RobaLinan/dual-ink-reader/DESIGN.md

# 双屏对折电子书 · 设计文档（方案 v4）

> 参考项目：The Open Book（单屏，字库/分页经验）、atomic14 diy-esp32-epub-reader（软件分层）、**Diptyx**（双 5.83" 对折，硬件形态几乎相同，MIT）。
> 屏幕：GDEY0583T81 ×2，648×480，UC8179 控制器，138dpi，带转接板模块。
> 全刷 3s / 快刷 1.5s / 局部 0.3s（数据手册 §7.2）。

## 1. 引脚分配

### 1.1 ESP32-S3 N16R8（目标板）
```
墨水屏（SPI2，两屏共用 SCK/MOSI）：
  SCK 12, MOSI 11
  左屏：CS 14, DC 15, RST 16, BUSY 17
  右屏：CS 18, DC 21, RST 47, BUSY 48     ← 右屏构造时 mirrored=true
SD 卡（SDMMC 1-bit，4-bit 实测不稳，见 §5.7）：
  CLK 38, CMD 39, D0 40（D1/D2/D3 不接线，41/42/13 空出备用）
按键（低有效，内部上拉 + 板载 10k；**不参与唤醒**——唤醒只走霍尔，2026-10-08 定案）：
  PREV 1, NEXT 2, MENU 9, FONT 10
霍尔 DRV5032 OUT：4    （全极性开关型；误买锁存型则唤醒逻辑改"任一沿都醒"）
电池电量：**当前不用**（原理图已删 BAT_SENSE，GPIO8 空出）；（如需：优先电池包自带指示灯，否则 5V 分压进 GPIO 8（ADC1_CH7，软件滤波、不加电容））
备用：5, 6, 7、41、42、13
```
避开：strapping 0/3/45/46、USB 19/20、**内部 Flash 占用的 26-32**、八线 PSRAM 占用的 33-37、UART0 43/44。
> P3 实测教训（2026-09-24）：SD CMD 误接 GPIO29 → `sdmmc_init_ocr` 0x107
> （卡无应答）。26-32 是 N16R8 内部 Flash 引脚，硬件占死，任何外设都不能用。

编译 FQBN：`esp32:esp32:esp32s3:PSRAM=opi,FlashSize=16M,PartitionScheme=app3M_fat9M_16MB,CDCOnBoot=cdc`
> 分区表实际以 sketch 根目录 **`partitions.csv`** 为准（platform.txt prebuild 钩子
> source > variant > build.partitions 自动覆盖菜单项）——菜单选 `app3M_fat9M_16MB`
> 只为借它的 `upload.maximum_size=3MB` 做体积上限检查。详见坑 22。

### 1.2 经典 ESP32 Dev Module（❌ 已废弃 —— 代码不再支持，仅存档）
> P3 起 sketch 只面向 ESP32-S3（`CONFIG_IDF_TARGET_ESP32S3` 分支已删）。
> 旧面包板接线：BUSY 13, RES 12, DC 14, CS 27, SCK 18, MOSI 23。

## 2. 电源
```
5V 电池包 → 开发板 5V/VIN 脚
开发板 3V3 脚 → 屏L/屏R VCI（各加 100µF+100nF 就近去耦）、SD 模块、DRV5032、按键上拉
```
**电池包选型硬指标：必须无自动关机/支持常开**（深睡整机几十 µA，普通充电宝低电流自动断电后唤不醒）。
**电流尖峰预案**：双屏重叠刷新峰值 300-400mA。原理图已放 **Ams1117** 位（3P 端子 + R12/R13 0Ω，**默认 DNP**，WIRING §3.8）；若实测重启 → 贴上模块（注意它与开发板 3v3 输出并联对顶，且静态 ~5mA 会毁掉深睡 µA 目标）。
深睡时屏 VCI 保持供电（DSLP 约 1µA），唤醒直接差分刷新。

## 3. 驱动要点（src/EinkPanel.* + src/DualEink.*）

与 vendor 代码（legacy/EPD.cpp）的本质区别：
1. 引脚全部构造参数化 → 可实例化左右两屏
2. `waitIdle(timeout)` 带超时 + 喂狗（vendor 是无超时死循环）
3. `showDiff(prev, next)` 的 DTM1(0x10) 写**真实上一帧**（nullptr=全白）；
   vendor 每次灌 0xFF，等于控制器以为屏本是白的 → 残影根源
4. 三档速度 = 寄存器组合：
   | 档位 | 0x50 CDI | 0xE0 | 0xE5 | 实测（单屏 / 双屏重叠 L+R） |
   |---|---|---|---|---|
   | FULL | 0x21 0x07 | 0x00 | — | **3749ms / 3815ms** |
   | FAST | 0x29 0x07 | 0x02 | 0x5A | **1232ms / 1306ms** |
   | PARTIAL | 0xA9 0x07 | 0x02 | 0x6E | ~0.3s（待实测） |
   0xE5 本质是**强制温度寄存器**，靠假装高温让控制器从 OTP 挑快波形；
   开关在 **0xE0 的 TSFIX(bit1)**：1=用 E5 强制值，0=用内置温度传感器（复位默认）。
   ⚠️ `setSpeed(FULL)` 必须把 0xE0 写回 0x00，否则快刷后再全刷会沿用强制温度的
   快波形 → 清不干净残影（已修，UC8179.pdf §46/§49 确认）。
   5. `DualEink::present()`（P2）：左灌帧→DRF→趁左 busy 给右灌帧→DRF→等两屏 idle。
   对照 Diptyx `DisplayPictureBoth()`，同一形状；单屏串行 2×1.3s → 重叠 ≈max+60ms
5. `mirrored=true`：流式发送时做字节序反转+位反转（右屏物理倒装）
6. BUSY 高电平 = 空闲（此模组极性，与 vendor 注释 "=0 BUSY" 一致）
7. **页面方向（2026-09-28 改：短边为横边的竖版页）**：屏恒是 648×480 横版
   显存，排版则按竖版页 `PAGE_W`(480) × `PAGE_H`(648) 走。旋转不自己拷缓冲，
   交给 `Paint_NewImage(..., PAGE_ROTATE)` —— GUI_Paint 的 `Paint_SetPixel`
   逐像素做坐标映射（**90 = 页顶朝屏右边**，阅读时把设备逆时针转 90°；
   270 = 反向，改 `EinkPanel.h` 的 `PAGE_ROTATE` 或编译加 `-DPAGE_ROTATE=270`）。
   所有绘制（`Paint_Draw*` + `CJK.drawGlyph`）都经 `Paint_SetPixel`，所以零额外
   缓冲、零旋转拷贝；差分/DTM1/`mirrored` 仍在显存坐标上原样工作。
   ⚠️ 代价：`Paint_SetPixel` 边界判断是 `>` 不是 `≥`，**逻辑 x=480 会写穿显存**
   （旋转后 x→显存行号，SetPixel 内部拦不住）→ 三处钳位是硬需求：页眉超长
   截断（`TxtBook::drawHeader`）、行宽硬上限 464（`HARD_PX = PAGE_W-16`）、
   CJK ink 出界丢弃（`CjkFont::drawGlyph`）。离屏回归见 §6
   `tools/rot_layout_test.cpp`（哨兵带验证最坏排版零越界 + 反例确认 x=480 必穿）。

**P1 实测数据**（eink.ino demo，串口 115200，ESP32-S3 实测 2026-09-23）：
```
full refresh #0: 3749 ms (ok)
fast refresh #1: 1232 ms (ok)
fast refresh #2: 1232 ms (ok)
fast refresh #3: 1232 ms (ok)
```
⚠️ P1 首版"刷完花屏"根因：demo 漏调 `Paint_NewImage()` → GUI_Paint 全局
Width/Height/Scale=0，`Paint_Clear` 空转、所有绘制被边界检查丢弃，帧缓冲一直
是 malloc 垃圾。SPI/时序本身没问题（耗时数据是真实的）。

**P2 实测数据**（双屏 `DualEink::present()` 重叠刷新，2026-09-23）：
```
both panels OK - dual overlapping mode
full refresh #0: 3815 ms (ok)     ← 单屏 3749ms，重叠代价仅 +66ms
fast refresh #N L+R: 1306 ms (ok) ← 单屏 1232ms，重叠代价仅 +74ms（右屏灌帧 60ms 藏在左 busy 里）
100 次连刷（每 5 快插 1 全）：0 超时 0 花屏 0 重启
```
⚠️ P2 首版"上电全刷花屏"根因：setup 把页 0 画进 fbShown，而 refreshPair()
固定拿 fbDraw 当新数据 → 首帧 DTM2 = malloc 垃圾；且 setup 漏了 swapPair()。
修法 = 四缓冲先 memset 白 + 画进 draw 缓冲 + 收尾 swap（双缓冲纪律：
shown 永远 = 屏上真实内容）。
**双屏同刷电流峰值未实测**（手头无表）；100 次无重启 = 供电间接通过，
若日后出现重启按 §2 预案上 AMS1117。

## 4. 分阶段路线
| 阶段 | 内容 | 验收 |
|---|---|---|
| P0 ✅ | 去损坏引用，旧驱动移 legacy/ | 编译通过 |
| P1 ✅ | EinkPanel 类 + 翻页 demo | 全刷/快刷实测、20 次快刷残影可接受 |
| P2 ✅ | 第二块屏 + `DualEink::present()` 重叠刷新（对照 Diptyx 固件） | 整页 ≤1.8s ✅（实测 1306ms）、100 次无花屏无重启 ✅、双屏电流待补测（无表；100 次无重启=间接通过） |
| P3 ✅ | SDMMC + UTF-8 + 字体 + 断行 + 分页 + 霍尔深睡（2026-09-24 收官；4 键已挪 P6） | TXT 中英混排；合盖深睡开盖 2s 恢复 —— 全过 |
| P4 ✅ | miniz + tinyxml2（锁版本，src/VENDOR.md）+ 书库 + 进度 + **EPUB 插图** | EPUB 读完一章不崩不 OOM（>280KB 章节流式）✅、章间翻页/切书/进度回页 ✅、插图清晰不重启 ✅ —— 屏上实测通过（2026-09-28；插图首测揪出坑 21 两 bug 已修复测） |
| P5 ✅ | 跨页语义：左 N / 右 N+1（DualEink 双屏 + renderPair/turnPage 对页栈 48 深） | 翻 50 页内容连续 ✅ |
| P6 ✅ | 3D 打印底板 + 铰链 + 10 芯排线 + 板载按键 + **4 键逻辑**（src/Keys ISR 边沿队列 + poll 判定）；**备料清单见 `BOM.md`** | 连续翻页无复位 ✅；唤醒定案只霍尔走 EXT1 ✅；按键电气台架 10 连按不漏不错位 ✅ |
| P7 | 打磨：电量/封面页/VCOM 逐屏标定/温度补偿 | 待机 ≥1 月 |

> **P3 收官 ✅（2026-09-24，全项屏上目检通过）**：
> - **SD**：分目录 `/fonts` `/books`（根目录旧布局兜底）；冷上电挂载
>   **指数退避重试 ×5 + "/" 根目录探针**防"begin 成功但开文件失败"的半成功
>   挂载（坑 15 定案：卡与双屏共用 3V3、上电爬升慢，固定 100/200ms ×3 覆盖
>   不住最坏就绪窗口，连挂 9 次全败实测；根目录探针顺带修掉"冷开候选 1 静默
>   换书"——开机读英文、唤醒读中文的根因）
> - **排版**：UTF-8 中英混排分页——汉字按字断行、英文按词断、避头尾、
>   纯英文不回退、EOF 回卷；Unifont 整载 PSRAM（板型必须选 OPI，`[mem]` 常驻
>   探针可观测）
> - **字体自定义**：三档字号 16/24/32（串口 `s`）+ 四家族 EPF1 离线字库
>   classic/serif/sans/kai（`tools/mk_fontpack.py` 离线光栅化 → SD 扫描自动
>   发现 → PSRAM/heap/桶缓存三级装载 + Unifont 回退链 → NVS 持久化，
>   串口 `f` 切换即预览）
> - **霍尔深睡全链路**：合盖 300ms 防抖 → 屏上对页位置存 RTC 内存 → SPI 8 脚
>   `gpio_hold`（防深睡浮空噪声刷屏）→ EXT1 深睡；开盖唤醒重画对页进 RAM、
>   **只同步 shown 不推送面板**（VCI 常供图像没丢）= 零闪烁恢复原页，下一翻页
>   diff/DTM1 正确；loop 5s 整段 delay 改 20ms 分片轮询。台架
>   （`hall_sleep_test/`）验证 EXT1 唤醒 526–576ms、醒后仍合盖自动再睡；
>   集成后合盖睡/开盖回页/醒后翻页不花屏/多轮循环/RST 释放 hold 全过
> - **交接**：4 键过渡期用串口 `f`/`s`（`setTier`/`setFamily` 接口已备好），
>   4 键 / 电池包不自动关机验证在 P6
>
> 下一步 → **P5**：跨页语义。
>
> **P4 ✅ 收官（2026-09-24 编译 + 主机端管线验证 → 2026-09-28 屏上实测通过）**：
> - **vendored 锁版本**：miniz 3.0.2（zip 解压，原样）+ tinyxml2 10.0.0
>   （打 1 类补丁：定义 `TIXML2_PSRAM_POOL` 时 MemPoolT 4KB 池块 +
>   `_charBuffer` 文档缓冲走 ps_malloc，失败回退 malloc——>280KB 章节的 DOM
>   不挤 250KB DRAM；补丁位置/升级注意见 src/VENDOR.md）
> - **一章一转换**（`EpubBook` 组合 `TxtBook`，排版引擎零重写）：
>   miniz 流式解压章 XHTML → 片内 LittleFS 临时文件（坑 6 定案路径；**坑 18
>   起临时文件不写 SD**，SD 写会物理锁卡）→ 整章读进 PSRAM
>   （444KB 实测装得下）→ tinyxml2 解析 → DOM 抽正文（跳过 style/script/head，
>   块级补 \n，空白折叠，连续空行封顶 2）→ 2KB 缓冲写 LittleFS 临时文本 → TxtBook
>   当 TXT 翻（三档字号/四家族/避头尾全继承）。解析失败自动降级"剥标签"兜底
> - **章末推进**：TxtBook 加 setLoop(false)/hitEof()；右页中道结束画空白页，
>   下一对页自动进下一章，坏章自动跳过（guard 防死循环），全书读完回卷
> - **实体预替换**：tinyxml2 只认 5 内置实体、其余原样透传 → 解析前压缩式
>   单遍替换 &nbsp; &ldquo; &mdash; &hellip; 等（UTF-8 BOM 顺手剥掉）
> - **书库 + 进度**：开机扫 /books/*.txt + *.epub（根目录旧布局兜底），串口
>   `b` 切下一本；进度（路径+章号+章内偏移+页号）存 NVS，每 10 对页/切书/
>   深睡时落盘，冷启动按存档恢复；深睡 RTC 增加章号，开盖回页对 EPUB 同样零闪烁
> - **顺手修**：CjkFont::setFamily 同家族同档短路（否则 EPUB 每章切换会把
>   kai 几 MB 字库包从 SD 反复整载）；TxtBook::open 允许重开（关旧文件）
> - **测试书**：`tools/mk_test_epub.py` 生成 assets/books/test.epub（3 章，
>   第二章 444KB >280KB 验收线；混入中文/英文/实体/弯引号/br/嵌套/脚本）；
>   主机端用同款代码 + vendored tinyxml2 验证：三章全解析成功、实体全替换、
>   script/style 零泄漏、无三连空行

**P4 插图 ✅ 收官（2026-09-28，主机端路径解析验证 + 屏上首测 → 揪出两个
bug 已修（坑 21）→ 复烧回归通过）**：
- **管线**：转换期 `collectText` 遇到 `<img>`/`<image>`(svg 封面) 不写文本，
  写 `[[img:zip内路径]]` 标记行（src 相对本章 XHTML 解析：`../` 折叠 + `#` 截
  锚 + %XX 解码 + 空格转 %20 防拆词）→ TxtBook 排版到标记 = 独占一块行高：
  回调量高（只读文件头）→ 页中放不下整图推下页（新 s_rewindPos 页尾回退，
  与行回退互补）→ 页首硬压进一页防死循环 → EpubBook 解压图片条目到
  LittleFS 临时文件（同路径缓存，防 restartPair 重复解压）→ `EpubImg` 解码
- **解码**（详见 src/VENDOR.md）：JPEG = vendored **ChaN TJpgDec R0.03**
  （块回调无整图缓冲，RGB565 输出，3.5KB 工作区；坑 19：S3 ROM 版 esp_rom_tjpgd
  调试不可达已弃用——根因是 ChaN 输入回调"NULL buf = 跳字节"约定未实现）；
  PNG = PNGdec 库（35KB 对象堆分配，栈放不下，坑 16 同因）。
  两路都走 4×4 Bayer 有序抖动 → Paint_SetPixel 落帧缓冲（白底只点黑）；
  渐进 JPEG / 隔行 PNG / GIF / WebP 跳过不阻塞排版
- **主机端验证**：路径折叠镜像脚本对三本书全量过——test 3/3（含 ../ 引用）、
  alice_rackham 42/42、christmas_carol 11/11（含 svg xlink:href 封面）全部
  命中 zip 条目；三书图片路径最长 44B（标记 ≤52B，词缓冲 192B 无溢出）；
  全部 JPEG 均 baseline、PNG 均非隔行（解码器可解）。test.epub 的假 8B pic.png
  换成真 400×240 灰阶渐变 PNG（考缩放 + 抖动）
> - **验收清单 ✅（2026-09-28 屏上实测全过）**：①开test.epub 翻完 444KB 章不崩不 OOM
>   （串口盯 `[epub] chapter ... psram free=` 与 `[mem]`）②章间翻页连续无重页
>   ③合盖开盖回页（含章号）④`b` 切书 ⑤字体/字号切换即预览对 EPUB 生效
>   ⑥插图（alice_rackham）灰阶抖动观感可接受、无涂抹、翻到图页不重启
>   （坑 21 修复后复烧）—— 插图显示效果定案，后续不再动解码/抖动参数
>
> **P6 ✅ 收官（2026-10-08 → 2026-10-12，PCB 实装 + 按键电气台架 + 4 键逻辑 + UI 美化）**：
> - PCB 打样回来已装机，屏/SD/霍尔/按键功能正常（按键为首次上板）
> - `key_test/`（P6 新增台架，对应 `hall_sleep_test/`）：上电空闲 4 脚全高
>   （原理图 BTN_* 误标 GND 坑实测排除）、4 键各 10 次连按 10/10/10/10
>   不漏不错位、去抖 20ms 全程 `bnc=0`、2/3/4 键组合正确识别且计数同步
>   （无连锡）、静置 80s 电平恒高零漂移；长按 115–800ms → **短按阈值
>   定 ~250ms** 依据
> - ✅ **唤醒定案（2026-10-08）：按键不参与唤醒，只有霍尔走 EXT1** ——
>   `eink.ino:491` 的 `ANY_HIGH` 一行不改，按键低有效不进掩码，极性冲突
>   随之消失（原备选"改 ANY_LOW+霍尔反相 / 按键改 ULP/GPIO wake"全部不需要）。
>   代价：合盖深睡时按按键不叫醒设备（阅读流 = 开盖醒 → 按键翻页，可接受）；
>   深睡中按过的键表现为"醒后首读为低"，4 键逻辑忽略开机首个低电平
> - ✅ **4 键逻辑已落地（2026-10-08，编译 993KB/75%，已烧录待屏上验收）**：
>   - `src/Keys.h/.cpp`：**ISR 边沿队列 + poll 判定**——刷新阻塞 1.3s/3.8s，
>     轮询会把刷新窗口内的按压整段漏掉（翻页时最常按的就是刷新中），ISR 只
>     记 (时刻,脚,电平) 进 16 槽环形队列，去抖 20ms/长按 250ms/连发 300ms
>     全在 poll 判；醒后被按住的键不补发按下（不产生幽灵事件）；电平兜底
>     （m_down 与引脚背离满一个去抖窗 → 补发释放，防抖动沿卡死成幽灵翻页）
>   - `eink.ino turnPage()`：**对页历史栈 48 深**（Book 接口只前进，上一页靠
>     坐标回退 restorePair→renderPair）；连按并批成净位移（一次刷新 1.3s 内
>     攒下的按压跨 N 页只刷一次屏，中间页也进历史栈可逐页回退）
>   - 键位：Prev/Next 翻页（长按连发）、Font 短按字号 `s`/长按家族 `f`、
>     **Menu 短按 = 主页（选书）/ 长按 250ms = 系统菜单**（P7 改，见 §9）；
>     菜单内 Prev/Next=上下、Font 短按=执行、Menu=退出；主页内 Prev/Next=
>     上下选书、Font 短按=打开选中书（`src/HomePage.*`）
>   - **自动翻页默认关**（串口 `a` 开 = 台架测试用），真实阅读不自翻
> - 📌 **已记录在案、暂不修的边角问题（2026-10-08 代码评审）**：
>   ① Font 按下发生在菜单打开前、松开在打开后 → RELEASE 会误执行菜单当前项
>     （`g_keyDown` 不区分按下时的菜单状态；修法：开菜单时清一次 `g_keyDown`）；
>   ② 菜单内按住滚动比书页模式慢一拍：菜单只认 PRESS/REPEAT，LONG 事件被吞，
>     首拍连发要等"长按+连发"周期（书页模式 LONG 本身也算一步，两侧节奏不同）；
>   ③ 开机窗口（setup 数秒）内按的键会攒成真实事件、boot 后集中兑现 → 可能
>     开机即翻页/开菜单（串口侧有 `harvestRx("boot")` 先例；按键侧如需冲洗：
>     setup 末尾空转一轮 `keys.poll()` + `while (keys.take(ev))`）
> - ✅ **屏上验收通过 + UI 美化（2026-10-12）**：4 键翻页/回退/菜单/字号全过；
>   主页/菜单 UI 美化（选中项实心三角+粗下划线、分节标题带方块标记、状态
>   实心/空心圆点指示、页脚居中、粗细分隔线区分层级）

## 5. 已知的坑（详见方案文档）
1. 电池包自动关机 → 深睡报废（选型硬指标）
2. 双屏同时刷新电流尖峰 → LDO 重启（大电容去耦优先，AMS1117 兜底）
3. 双屏 SPI 争用 → 严格"选片→传输→释放"，提前 return 前先放 CS
4. 绝不在 MCU 上排整本书（The Open Book：20 分钟且会崩）→ 按章排版 + SD 缓存
5. CJK：UTF-8 在分词处解码；CJK 按字符断行 + 避头尾；Unifont 存 SD 流式查表
   **→ 已落地（2026-09-24）**：字库 = GNU Unifont 18.0.01 → `tools/mk_unifont.py`
   生成平坦 `unifont.bin`（65536×32B = 2MB，`offset=cp*32` 免索引直接 seek；
   8×16 半宽左对齐补零到 16 列；辅助平面 66225 条 BMP 之外跳过；缺字画 16×16
   空心方框区分"缺字/空白"）。`CjkFont` 优先整块 ps_malloc 进 PSRAM，失败回退
   逐字形 SD seek+read。排版按像素宽：ASCII 11px / CJK 16px / 空格 11px，
   **竖版页 480 宽**（方向见 §3.7）：软预算 448px，硬上限 464px（`PAGE_W-16`，
   `Paint_SetPixel` 边界是 `>` 不是 `≥`，逻辑 x=480 会写穿显存 → 悬挂吞右边距
   也绝不能超 464）。断行四层：
   避头悬挂 → 上一 token 推挤到下一行同行（携带的前导空格剥离并恢复原
   pendingSpace）→ 普通换行 → 超长词 cutPoint 硬切。西文弯引号/长横线仍归一
   ASCII 走 Font16，英文行宽与旧版一致（不回退）。`Font12CN/Font24CN` 只有
   extern 无定义，链接不过 —— 不可用。
   **三档字号（2026-09-24 增）**：`TxtBook::setTier(16/24/32)`。S=Font16 原生
   11px+Unifont16/行高18/33行；M=Font24 原生 17px+Unifont 1.5× 最近邻/28/21行
   （笔画略参差，可接受）；L=Font16 点阵 2× 放大 22px+Unifont 2×/36/16行（整齐）。
   运行期切档：串口 `s` / **Btn_Font 短按**（P6）；默认档改 `TxtBook.h` 的
   `TXT_SIZE_PX` 再编译。
   行数不再写死，`updateGeometry()` 按 `TXT_BOT(=PAGE_H-18)` 与墨迹盒算（换页高
   只动 `TXT_BOT`）。软行宽 = 464−汉字档宽（448/440/432），悬挂后仍 ≤464 不越屏；
   缺字方框随档 1px/2px 加粗。页眉固定 16px 不随档位，长文件名在 `drawHeader()`
   按 480 宽截断。
   **字体自定义（2026-09-24 增，Kindle 式）**：家族包 `font-<名>-<档>.bin`（EPF1）
   离线从任意 TTF 光栅化（`tools/mk_fontpack.py`），拉丁带真实 advance（比例宽度），
   汉字/全角等宽；一笔紧凑 ink（cp/adv/xy 偏移/w/h/bits），PSRAM 整包 → heap →
   SD 桶缓存三级装载，查表走 u32[257] 桶索引线性扫（≤256 条）。缺字回退：
   家族包 → Unifont（对齐包基线）→ 方框。行几何随包度量联动（基线/行盒/行距
   = 盒+档宽/8）；软预算与 classic 同为 464−档宽（悬挂另有显式 HARD 检查兜底）。
   切换：串口 `f`=换家族 `s`=换字号（**P6 已绑按键**：Btn_Font 短按=s / 长按=f，
   见 WIRING §3.4），选择存 NVS 断电保留；
   `restartPair()` 回跳当前对页立即重排 = 切换即预览。家族 classic/serif/sans/kai
   四款全就绪（kai=霞鹜文楷 43433 字形，2026-09-24）。 ink 出界自兜底（竖版页逻辑 x≤479/y≤647，Paint 边界是 > 不是 ≥）。
6. EPUB >280KB 章节崩分配器（atomic14 #73）→ 先解压到临时文件再流式（坑 18 后 = 片内 LittleFS）
7. SDMMC × core 2.0.17 × S3 兼容性 → **P3 首验（2026-09-21）：4-bit 不稳定，定案 1-bit @20MHz；写 2MB / 1417ms ≈ 1.41MB/s**。**二验（2026-09-24）：正式引脚 38/39/40 挂载成功，/test.txt(151KB) 流式分页正常（24 行/页，读+渲染 ~30ms/页，对比 1.3s 刷屏可忽略）**。
   ⚠️ 踩坑：初始化 `0x107`（卡无应答）→ **CMD/D0 需要内部上拉兜底**（`pinMode(INPUT_PULLUP)` 再 `setPins`）——模块没焊总线上拉时 CMD 浮空；8.21 的 one_bit_write 带这两行、初版 Storage 漏抄。D1/D2/D3 1-bit 用不到，但**卡座侧上拉到 3V3 后写路径转稳**（09-28 复测，见坑 18 末段）——用 10kΩ 上拉，**别直连 3V3**。
   **写后读回校验 → P4 首测未过（2026-09-28，坑 18）**：正式引脚写 ~3KB 即 0x109
   锁卡；EPUB 已改片内 LittleFS 临时文件绕开 SD 写。
   **复测通过（2026-09-28 晚，`sdcard/one_bit_write` v3）**：正式引脚 38/39/40 @20MHz
   连续两轮 **2MB 写 + 整档读回校验全过**，读 1.92MB/s、写 0.25MB/s（4KB/次；
   32KB 大块吞吐用 G 档待测）。⚠️ 归因未收口：断电重插（锁死卡复活）和
   **DAT1/2/3 接 3V3** 是同时做的两件事，A/B 复测（断开 DAT1-3 再跑）没做。
   **→ 同上电三轮复跑（09-28 晚，坑 18 末段表）翻案**：4KB 多块写 **3/3 必挂**、
   512B 单块写 2/3 过 2MB、节流与降频全无效 → 写路径仍在边际，**写小块只是缓解**。
   **固件已落地（09-28）**：`NetSvc` 上传 `/books` 改 512B 对齐分块写（强制单块
   CMD24，HTTP 分块先在 `m_upBuf` 攒够一扇区再落盘）+ 落盘字节对账 + close 后回读
   校验 size + 失败先 `Storage::recover()` 再删半截文件。原实现一失败就把整张 SD
   锁死到断电、且弹"卡满或写保护"误导文案。
   **→ 首测（09-28）仍失败**：512B 单块写在 289.6kB 文件的第 **29696 字节（10%）**
   就挂，且 recover 报 OK 后 `remove` 仍 0x107 = 恢复假阳性（挂载≠能写，见坑 18 末段）。
   待补：深睡唤醒后重新挂载、G 档 32KB 大块写速、DAT1-3 断开的 A/B 复测、
   **换卡排除 + 卡座 VDD 去耦 + CMD/D0 47k 上拉（排查三件至今一件没做）**；
   真不稳再回退 SPI（接口不变）
8. 同型号两块屏 VCOM 不一致 → CDI(0x50) 左右分开标定（Diptyx 做法）
9. 残影 → 每 5 次快刷插一次全刷
10. `0xE5` 强制温度 → 对比度略降；后续用面板温度传感器（0x40 TSC/0x43 TSR）补偿
11. 结构装配时 USB 座外壳通孔必须焊/固定，否则连焊盘撕掉（Open Book 教训）
12. GUI_Paint 用前必须 `Paint_NewImage(buf, W, H, PAGE_ROTATE, WHITE)`（W/H 是
    **显存** 648×480，旋转定竖版页方向，见 §3.7），之后各画布只
    `Paint_SelectImage` 切换 —— 漏了 NewImage 不报错不崩溃，只是全部绘制静默丢弃
    （P1 花屏根因）。宽高/旋转只认 NewImage 那一次，SelectImage 只换指针
13. 右屏 BUSY 用 GPIO48 = DevKitC-1 的 RGB LED 脚：LED DIN 高阻无电气冲突，
    但刷新时 BUSY 信号会让 LED 闪 —— 属正常现象，别当故障查接线
14. 设计外壳时预留出esp32s3的rst和boot按钮针孔
15. SD 冷上电首挂偶发 0x107（卡与双屏共用 3V3 轨，上电爬升慢、卡 POR 就绪晚；
    复位键不断卡的电，故 reset 后首挂即成。2026-09-24 实测：固定 100/200ms
    重试 ×3 覆盖不住最坏就绪窗口，4 个候选文件各试 3 次连挂 9 次仍全败）→
    `Storage::begin()` 改**指数退避 ×5**（200/400/800/1600ms，每次重试重拉
    CMD/D0 上拉 + setPins，end() 会拆引脚配置），挂载成功后加**根目录探针**
    （open("/") 失败视为半挂载拆了重来——挂载过了但首开文件失败的症状同源，
    TxtBook/CjkFont 开文件另带 100ms 退避重试 ×3）；挂载失败不缓存只是兜底，别依赖它
16. miniz `extract_to_callback`/`extract_to_mem*` 把 `tinfl_decompressor`（≈8.2KB）
    放**栈**上 → `loopTask` 默认 8KB 栈进函数即溢出（2026-09-24：开机串口 `b` 切到
    EPUB 直接 reboot，栈顶 `|<-CORRUPTED`）→ `EpubZip` 改走迭代式
    `extract_iter_new/read/free`（解压器状态在堆分配的 iter_state 里），零补丁，
    详见 `src/VENDOR.md`。**排查口诀**：EPUB 独有路径崩 = 先查 miniz/tinyxml2 的
    栈上大数组，TXT 路径不经过它们所以"之前一直没事"
17. miniz 32 位堆越界（上游 richgel999/miniz#371，**未发布修复**）：`tinfl_decompress`
    在 xtensa 32 位上写越 `tinfl_decompressor` 尾部（64 位主机不复现），落在
    `mz_zip_reader_extract_iter_state` 尾部字段上 → `file_crc32` 被踩成确定性
    字节序列，`iter_free` 的 CRC 校验必败。两段缓解（`EpubZip.cpp` 头注释）：
    ① 所有 miniz 分配 +4096 超配（保护堆上相邻分配）② 调用侧用栈上 `own_crc`
    回填 `file_crc32`（栈变量越界够不着）——尺寸检查保留。诊断法见代码内注释
18. **SD 卡写入物理锁卡**（P4 首测 2026-09-28）：读全程正常（TXT 分页、zip 流读、
    字库 seek 都稳），但正式引脚 38/39/40 写临时文件 ~3KB 后驱动层报 0x109
    （应答 CRC）→ 此后**读写全 0x107 超时**，`Storage::recover()`（CMD0 重挂）
    也救不回，只能断电重插 = 卡写入期 VDD 塌陷/信号边际的典型症状（小文件
    244/821B 写得过，持续写电流尖峰才顶不住；也不是 miniz 踩内存——全程
    `heap ok`）。注意：2MB 写测速是**旧引脚 10/11/12**（现屏脚）的成绩，
    正式引脚从来没验过写（§5.7 待补项）。→ 固件侧已根治：EPUB 临时文件
    （container/OPF/xhtml/文本）全部改走**片内 LittleFS**（根目录 `partitions.csv`
    定制的 spiffs 分区 9.9MB，`LittleFS.begin(true)` 首启自动格式化，见坑 22），**EPUB/渲染路径对 SD
    零写入**（进度在 NVS），EPUB 不再受卡写能力影响；唯一的 SD 写点是网页上传
    `/books`，已按坑 18 改 512B 单块写（见第 7 条"固件已落地"）。硬件侧待办（做板 checklist
    见 WIRING §4）：卡座 VDD 10µF+100nF 就近去耦、CMD/D0 实体 47k 上拉、
    换卡排除、仍不稳则降频 10MHz；复测工具 `sdcard/one_bit_write`（已改 38/39/40）
    **→ 复测曲线（09-28 晚，工具 v2/v3）**：同一张卡连跑 4 轮 = `20MHz 写到 16~80KB
    挂（0x107 数据超时，偶发 0x109）→ 每次 CMD0 能救 → 降到 10MHz 反而更早挂、连读
    都挂 → 单次写卡死 181s → CMD0/ACMD41/CMD2 全超时彻底锁死（只能断电重插）`。
    两条排除：**降频无改善 → 不是 20MHz 信号完整性**；节流写（4KB+200ms）只把
    触发点从 24KB 拉到 120KB、仍挂 → 也不是"停顿让电压恢复就能救"。**分块大小
    被证实有影响（09-28 晚第 5 轮，同轮同状态对照，最干净的一组）**：4KB 多块写
    （CMD25）C/D 两档**都精确挂在 24576 字节**，512B 单块写（CMD24）同轮完整过
    2MB + 读回校验、速度还都是 0.25MB/s → **多块写是更弱的路径**（更早一轮 512B
    曾在 57.5KB 挂过，所以是"更稳"不是"免疫"；早前那句"排除多块命令"已作废）。
    该轮另一件事：**锁卡后文件只剩 0 字节 = 写入数据真丢**（FatFS 的文件 size 只在
    `f_close`/`f_sync` 提交，close 那 5 秒超时 → size 没提交，留个 0 字节壳；每档
    又都写同一个 `/wtest.bin`，所以后一轮读阶段看到的"根目录无文件"其实是 0 字节）。
    随后**拔插重插 + DAT1/2/3 接 3V3（无外部上拉、无去耦电容）→ 连续两轮 2MB 写 +
    整档读回校验全过**（读 1.92MB/s、写 0.25MB/s）。⚠️ 那次两变量同时变，谁起的
    作用未收口（A/B 复测待做）；DAT1-3 收尾**改 10kΩ 上拉，勿直连 3V3**
    （4-bit / 卡测试模式会与卡输出对撞短路）。
    **三轮连跑定案（09-28 晚，同一次上电 / 同接线 / 同卡，工具 v3）**：

    | 档 | 上电首轮 | 第2轮 | 第3轮 |
    |---|---|---|---|
    | 4KB 多块 C/D | 挂 120K / 24K | 挂 0 / 24K | 挂 24K / 24K |
    | 512B 单块 E | 挂 456K | **✔ 2MB** | **✔ 2MB** |
    | 4KB 节流 F | 挂 24K | 挂 24K | 挂 24K |
    | 10MHz 轮 | 全废 | 全废 | 全废 |

    → **"只有上电首轮能过"证伪**（首轮反而最差，E 都挂）；"连续跑会退化"也不成立
    （第 2、3 轮的 E 反而过了）。站得住的只有：**4KB 多块写 3/3 必挂、512B 单块写
    2/3 过 2MB、节流无用、降频 3/3 全废**，挂点在 0/24K/120K/456K 之间漂移 =
    随机边际而非确定性软件 bug。**换卡、卡座去耦、CMD/D0 47k —— 排查三件至今
    一件没做**（VDD 去耦 + CMD/D0 47k 仍欠焊），软件侧对照已到头。
    **→ 固件 512B 分块首测仍失败（09-28）**：`NetSvc` 上传
    `/books/03最后的守护者.txt` 走新的 512B 单块写照样写失败。日志里
    `[SD] recover: OK (40 ms)` **之后**紧跟 `sdmmc_write_blocks failed (263)`
    （0x107）—— 那是 recover 之后的 `SD_MMC.remove()` 又写不进去 →
    **"恢复成功"是假阳性：挂载 + 开根目录能过 ≠ 卡能写**，与工具 10MHz 轮
    "挂载过、数据命令全 0x107" 是同一症状（`Storage::recover()` 的判据太弱，
    只挂载不验写，别拿它的返回值当"SD 可用"）。
    **→ 二次实测（09-28，同一文件 289.6kB）**：512B 单块写在 **29696 字节（58 扇区、
    约全文件 10%）** 挂，且这次**只有数据相超时 `sdmmc_host_wait_for_event 0x107`、
    一个 0x109 都没有** → **0x109 不是坑 18 的必要指纹**（工具判读口径已改，
    从"指纹"降级为"充分非必要"）：主形态是"卡收下命令、数据相却不肯放 BUSY"，
    应答 CRC 错只是同一根因的另一面 —— 两者同源 = 卡没完成编程。日志止于
    `recover: end + remount`（未见 OK，被截断或仍在重挂）。
    **→ 软件侧到此为止：换卡 / 卡座去耦 / CMD-D0 47k 等 PCB 落板后统一复测。**
19. **串口 RX 幽灵命令 + drain 吞输入回归（2026-09-28）**：三个阶段——
    ① 原始症状：EPUB 深睡唤醒后没发过 `b`，书被切走（日志反推 loop 首轮收到
    'b' 又收到 'h'，均紧跟 `full refresh`）→ 疑似全刷串扰 RX0（GPIO44，UART0，
    CDCOnBoot=Disabled）。
    ② 加 `drainSerial()` 防护后引出**回归**：drain 在 `runRefresh` 尾执行，而
    `handleSerial` 只在 loop 顶部跑一次 → **等待期（5s，用户输入主窗口）收到的
    字节滞留到刷新结束被 drain 全吞**，实测 7 个 `b\n`（`62 0a`）全灭、`b` 切书
    100% 失效。教训：**丢字节的防护必须放在字节到达的窗口内，不能放在下游**。
    ③ 终态方案（三窗口各归各位）：等待期改**每 20ms 轮询** `handleSerial` 即时
    执行（永不丢）；刷新期/开机期用 `harvestRx()` **收割验证**——恰好"一个命令
    字符 + 换行"（终端实测发 `62 0a`）入队补执行，裸字节/乱码打 hex 记
    `[rx] dropped`，纯换行（用户命令尾字节滞留）记 `[rx] ignore` 单独归档。
    验证：`b` 即时执行、三次深睡恢复全部准确续页、深睡后无幽灵切书。
    硬件侧仍待观察：RX 走线远离 SPI/屏升压、共地，接 USB-UART 小板时检查杜邦线
    是否和屏线绞在一起；若再出现 `[rx] dropped` 含命令字符的随机字节即噪声实锤。
20. **深睡自醒（待定案 2026-09-28）**：首次深睡后无故自醒（用户未开盖），后两次
    正常开盖醒。日志事实：那次也是 `cause=3 (EXT1)`，即 **GPIO4 真实跳到开盖电平
    才触发的唤醒**；且醒来后霍尔持续读"开盖"跨了两个翻页周期（约 19s）才重新
    "合盖"入睡——瞬态串扰毛刺做不到这点，只剩两种解释：(a) 盖子/磁铁实际被碰到
    （或合盖时磁铁就处于 DRV5032 阈值边际，静置后漂移出窗口）；(b) 传感器供电/
    走线在深睡初期有慢恢复扰动。同轮唤醒还观察到 SD 首挂 0x107 重试 1-2 次成功
    （坑 15 的唤醒版）。固件侧已加三路取证（下轮日志定案）：
    ① `[wake] slept Ns` 入睡→唤醒实际时长（RTC 时钟跨深睡，`s_sleepAt`）——
    **秒级 = 入睡瞬间毛刺/电平边际；分钟级 = 盖子真被打开过**
    ② `[wake] ext1 pins=0x..` 触发脚位掩码（确认是 GPIO4 不是别的脚）
    ③ `[wake] hall=N (closed/open)` pinMode 后立刻读——**EXT1 醒 + hall=closed
    = 毛刺自醒实锤**（醒来时电平已回落）；EXT1 醒 + hall=open = 盖子确实开着
    硬件侧排查（定案后再动手）：磁铁与 DRV5032 对位/气隙、合盖后轻敲看电平是否
    跳、GPIO4 走线远离屏升压。
21. **EPUB 插图"糊成一片" + 翻到特定页重启（P4 屏上首测 2026-09-28，主机端复现
    定案）**：两个独立 bug，alice_rackham.epub 上一个表现为显示糊、一个表现为翻到
    title.png 那页堆崩：
    ① **JPEG 对角涂抹（糊的根因）**：tjpgd 的 `JRECT` 是**闭区间**，`workbuf` 里
    `rx×ry` 个像素紧凑排列、步进 = `right-left+1`；`EpubImg::jpgOut` 少写 `+1`
    → 每行读取起点左移一格、逐行累积成 45° 斜纹，16×16 MCU 块还丢末行末列。
    主机端用同款 vendored tjpgd 解 cover.jpg 对比新旧索引：**83.9% 像素不同**
    （旧=斜纹糊成一片 / 新=清晰封面，`/tmp` 下 jpgtest）。顺带修：`JDEC jd` 未
    初始化，而 Bodmer 补丁版 `jd_prepare` **保留**入参 `jd.swap`（先读后清零回填）
    → 栈垃圾非 0 时 RGB565 整体字节交换、lum565 亮度全错；现显式 `memset`。
    ② **PNGdec 奇数宽度越界写（崩的根因）**：`PNGRGB565` 调色板路径按 `x+=2`
    （4bpp）/`x+=4`（2bpp）整组步进，奇数宽多写 1~3 个像素（上游库缺陷，未修）。
    title.png = 373 宽（奇数）→ 恰好 2 字节写穿 `malloc(373*2)` 的尾部魔数，
    下次 `free` 报 `CORRUPT HEAP: Bad tail ... 0xbaad5678 got 0xbaad0000` +
    `multi_heap_free` 断言重启——日志里崩溃点正是 title.png 解码途中（页 4 有
    提取记录却无 `[epub] image ... ok`）。主机端金丝雀实测：373 宽越 2 字节、
    372/400 宽 0 字节，与设备日志逐字节吻合。缓解（库未改）：`pngDrawCb` 行缓冲
    多留 4 像素吸收越界写，多出的垃圾像素不进画布。
    **排查口诀**：屏上图"糊"先怀疑采样/索引（步进、坐标映射），别急着怪分辨率；
    `CORRUPT HEAP ... Bad tail` = 精确越界 2~8 字节，先查行缓冲按宽度分配的地方。

22. **分区表选错 = EPUB 静默全废（2026-10-10 定案）**：`LittleFS.begin()`
    （src/EpubBook.cpp）不传 label 时**默认按 `spiffs` 找分区**；而 esp32s3 板型
    （core 2.0.17 boards.txt）菜单里带 16MB 数据区的两项 `fatflash`/`app3M_fat9M_16MB`
    数据区都叫 **`ffat`（FAT）**，数据区叫 `spiffs` 的项又全是 4MB/8MB 表——**没有
    "16MB + spiffs" 的菜单项**（`default_16MB.csv` 文件在 tools/partitions 里有，
    但 esp32s3 菜单不提供）。选错的症状：编译烧录全过，运行时 `begin()` 找不到
    分区 → EPUB 解压临时文件写不进 → **只有 EPUB 坏、TXT/SD 正常**，极难察觉。
    （2026-10-09 就抓到两份错构：项目缓存按 `app3M_fat9M_16MB`（ffat）编的，
    另一份按 `FlashSize=4M` 编的。）
    → **定案**：sketch 根目录放 **`partitions.csv`**（platform.txt prebuild 钩子
    自动覆盖菜单，优先级 source > variant > build.partitions，arduino-cli 和
    Arduino IDE 编译都生效）。表 = `app3M_fat9M_16MB` 布局、仅 `ffat`→`spiffs`：
    app0/app1 各 3MB（OTA 双槽保留），spiffs 9.9MB @0x610000，coredump 64KB；
    nvs/otadata 与 `default` 完全同址同大小（0x9000/0x5000）→ **换表后书进度/
    WiFi/字体设置不丢**；spiffs 换址 → `LittleFS.begin(true)` 首启自动格式化
    （临时文件本就易失）。菜单 FQBN 仍写 `PartitionScheme=app3M_fat9M_16MB`——
    只为借它的 `upload.maximum_size=3145728` 做编译体积检查（现 997KB/3MB 32%，
    default 表下已 75% 快顶）。验证：解码构建缓存 `eink.ino.partitions.bin`
    确认 `spiffs @0x610000/10112K`。

23. **EPUB 跨章卡顿的两个根因（2026-10-13 定案，§13）**：① 同章回退无条件重载
    ——`restorePair` 里 `ch >= m_nChapters || !loadChapter(ch)` 对合法章号短路求值，
    **每次回退都重新解压+解析整章**（commit b60ebb0 修：仅 `ch != m_chapter` 才载）；
    ② 跨章转换本身几秒到十几秒（解压+DOM+落盘落在按键路径上）→ core0 三槽预取
    消化（§13）。TXT 无感只因它的 restorePair 只 seek——排查"翻页慢"先分同章/跨章。

24. **FQBN 漏 `CDCOnBoot=cdc` = 串口静默（2026-10-14）**：esp32s3 板型默认
    `CDCOnBoot=Disabled`（boards.txt），`Serial` 走 UART0 引脚不进 USB——症状是
    烧录"成功"但 USB 串口一行都没有（连 boot 日志都像消失，ROM 消息走
    USB-Serial-JTAG 通道，取决于监视器打开时机）。IDE 用户靠 Tools 菜单存了
    "Enabled"不察觉，arduino-cli 裸 FQBN 必现。**所有编译命令必须带
    `CDCOnBoot=cdc`**（§6 与文首 FQBN 已补）。排查"没输出"先怀疑这个，别怀疑固件。

25. **WiFi 连接期间 `xTaskCreatePinnedToCore` 跨核建任务 = 永久自旋（2026-10-14
    定案，§13）**：IDF 4.4 双核 FreeRTOS 向另一核挂任务要拿跨核 scheduler 自旋锁；
    WiFi 连接在 core0 跑长临界区（关 cache/flash）时，core1 的获取永远转不完 →
    loopTask 与 idle1 同核全被饿死 → **无输出、无 panic、连任务看门狗都不触发**
    （TWDT 靠 idle 喂），表象与"硬件卡死"无法区分。三个实锤特征：① 无任务代码
    A/B 正常；② 卡死点随机漂移（加打印延迟就挤过去）；③ 拔卡/换卡无影响。
    → **所有 core0 常驻任务必须在 `net.begin()` 之前（setup 最早段）创建**，
    此后永不再建（`EpubBook::prefetchInit()` 幂等，eink.ino setup 调用）。

## 6. 本地工具
- **漫画 EPUB 对页合并**：`python3 tools/pair_manga_epub.py <in.epub> <out.epub>`
  （calibre 类一图一章的漫画 EPUB → 连续单图章两两合并成一章，双屏一屏对页
  正好左右面板各一页；svg 封面页/文字章不合并。需配合 §12 固件改动，
  2026-10-13）
- 编译：`~/.local/bin/arduino-cli compile --fqbn esp32:esp32:esp32s3:PSRAM=opi,FlashSize=16M,PartitionScheme=app3M_fat9M_16MB,CDCOnBoot=cdc '/home/roba/Nutstore Files/我的坚果云/Projects/Personal/eink'`
- 竖版页离屏回归（不接硬件，§3.7）：`GUI=$HOME/Arduino/libraries/ESP32epdx/src/GUI g++ -std=c++17 -I"$GUI" tools/rot_layout_test.cpp "$GUI/GUI_Paint.cpp" "$GUI/font16.cpp" -o /tmp/rot_layout_test && /tmp/rot_layout_test`
  （断言逻辑画布 480×648、最坏排版零越界、页顶朝右；改动排版常量后跑一下）
- 字库生成：`python3 tools/mk_unifont.py`（源 `unifont_all.hex` → `assets/fonts/unifont.bin`，已生成）
- **字库包（字体自定义）**：`python3 tools/mk_fontpack.py <font.ttf> assets/fonts --name <名字>
  [--sizes 16 24 32]` → `assets/fonts/font-<名字>-<档>.bin`（EPF1 格式：紧凑 ink 记录 +
  真实步进 + 全局基线度量，依赖 Pillow/fontTools）。已生成：serif（Noto Serif SC）、
  sans（Noto Sans SC）、kai（霞鹜文楷 LXGW WenKai，OFL 开源，三款都可自由转换）
  （kai 三档 43433 字形已生成，2026-09-24）
  - 设备启动扫 `/fonts/font-*.bin` 自动发现家族；**加新字体 = 跑一条命令 + 拷文件**
  - 行盒度量封顶 size×1.25/size×0.4（防竖排假名等离谱 ink 撑爆行距）
  - 阈值 96 二值化（Noto 细横笔灰度仅 ~108，128 会砍掉）
- **SD 卡目录布局**（与 `assets/` 一一对应，`cp -r assets/. <SD卡>/` 即部署完）：
  - `/fonts/`：`unifont.bin`（2MB，classic 模式 + 缺字回退，必需）+ 可选
    `font-<名字>-<16|24|32>.bin`（字体家族，缺某档自动回 classic）
  - `/books/`：电子书 `*.txt` **和 `*.epub`**（P4 起书库扫描两类，串口 `b` 切换）
  → 缺 `unifont.bin` 时汉字全画 16×16 空心框
- 霍尔深睡台架测试：`~/.local/bin/arduino-cli compile --fqbn esp32:esp32:esp32s3:PSRAM=opi,FlashSize=16M,PartitionScheme=app3M_fat9M_16MB '/home/roba/Nutstore Files/我的坚果云/Projects/Personal/eink/hall_sleep_test'`
  （合盖 300ms 深睡 / EXT1 开盖唤醒 / RGB 48 可视判定；极性反了改 `HALL_CLOSED_LEVEL`）
- 资料：`~/Downloads/Gdey0583T81/`（屏规格书 + UC8179 数据手册 + 官方 demo 压缩包）

## 7. 双核并行备忘（2026-09-24 讨论 · 页级预取未采用；**章级预取 2026-10-13 已落地，见 §13**）

**问题**：要不要 core0 读 SD、core1 渲染？

**结论：现阶段不值得** —— 瓶颈是电子纸物理刷新，不是计算。重叠掉的渲染只占周期 4–5%：

| 阶段 | 实测（fast 页周期） | 占比 |
|---|---|---|
| SD 读 + 解码 + 排版渲染 ×2 页 | 50–73ms（25–37ms/页） | ~4–5% |
| SPI 搬帧（27.6KB×2 @10MHz） | ~16ms | ~1% |
| 物理刷新 BUSY 等待 | **1311ms**（全刷 3826ms） | ~94% |

SD 读本身每页仅 1–2ms（1-bit@20MHz ≈ 2.5MB/s，每页几 KB）。

**讨论里站得住的两个出处**（不是速度，是这两点）：
1. 全刷 3.8s 期间 `present()` 阻塞 → 串口 `f`/`s`、霍尔轮询全停 = 固件"假死感"
2. P4 EPUB 章节头一次解析（miniz 解 280KB + XML 扫描）可能几百 ms，
   落在章节首页 = 可感知卡顿

**若将来并行，切口别切在"SD vs 渲染"**：`TxtBook` 是紧耦合流式管线
（读 chunk → UTF-8 解码 → 断词断行 → 直接画 fb），中间架生产者-消费者队列
复杂度高、收益 ≈0（读只占 1–2ms）。正确切口 = **整页预取**：后台任务独占
`txt` + SD + Paint，把下一对页渲进备用缓冲（三缓冲轮换 6 个 fb ≈ 166KB，
PSRAM 无压力），前台 loop 只 present + 换挡，换挡点一道栅栏。单写者模型天然无锁。

**本代码库会咬人的点**：
- `GUI_Paint` 是**全局单例**（`Paint_NewImage` 一个全局结构）：渲染必须始终
  单核单写者；想左右页各一核并行画 = 必花屏（P1 花屏同族问题）
- `TxtBook` 游标状态（`m_file/m_page/m_pairStart`）：`f`/`s` 的
  `restartPair()+renderPair()` 必须改成给渲染任务发消息，主线程不许直接碰
- 深睡协调：SPI 在飞绝不能睡（图像断半截）；霍尔触发要等 present 完成 +
  渲染任务静默，才能 `gpio_hold` → 单线程纪律升级成双任务握手
- 可行性无问题：`loopTask` 默认就在 core1，WiFi/BT 关着，core0 基本闲着

**更便宜的中间方案**（同样收益、零竞态）：`present()` 拆成"发帧 → 等 BUSY"
两段，在 BUSY 等待的 1300ms 里**单线程**渲染下一对页 —— 串口/霍尔在刷新间隙
即响应，省下的毫秒数与双核方案几乎相同。

**决策路径**：
1. 现在：不动（单线程 1.36s/页，达标 ≤1.8s）
2. P4 实测单页渲染 >100–200ms 或章节首页卡顿明显 → 先上"BUSY 期间渲染下一页"
3. 仍不够 → 再上 core0 预取任务（上面的单写者设计），收益门槛到了再付复杂度

**回看（2026-10-13）**：门槛以另一种形式到了——不是单页渲染慢（50–73ms 依旧），
而是**跨章转换**（几秒到十几秒）落在按键路径上。落地的是更保守的切口：
core0 预取"转换后的章文本"（三槽轮换），不碰 Paint/帧缓冲，单写者约束原封不动。
页级渲染预取（本节原设计）仍不做，BUSY 期间渲染下一页（中间方案）也不需要了。

## 8. 系统菜单与网络服务（2026-09-28 新增，src/NetSvc.* + src/SysMenu.*）

**形态定案**：屏幕菜单 + 串口导航（板载按键 Btn_* P6 已接线并绑同一接口：
`SysMenu::key(char)` 串口与按键共用，按键映射见 WIRING §3.4）；WiFi 配置走
SoftAP 配网页；OTA 开关同时管 ArduinoOTA（arduino-cli 网络上传）和网页 `/update`。

**菜单四项**（串口 `m` 开/关；菜单开着暂停自动翻页，合盖仍深睡）：

| 项 | 执行的动作 | 状态字 |
|---|---|---|
| WiFi 配置 | `startPortal()`：热点 `eink-book-<MAC后4位>`（开放），手机连上开 `http://192.168.4.1/wifi` 扫描选 SSID 输密码 → 存 NVS → 重启连接 | `[热点]`/`[已配]`/`[未配]` |
| WiFi 开关 | 射频总开关（`wifi` NVS 键，**默认关** = §2 省电定案；开且无凭据直接进配置热点） | `[开]`/`[关]` |
| OTA 更新 | ArduinoOTA(3232, 无密码) + 网页 `/update`（传 **eink.ino.bin**，⚠️ 不是 merged.bin） | `[开]`/`[关]` |
| 电子书上传服务 | 网页 `/upload`：`*.txt`/`*.epub` → SD `/books/`（重名覆盖），完成后回调 `onBookAdded` 重扫书库；`/library` 书库管理（下载/删除，删除回调 `onBookRemoved`，§10） | `[开]`/`[关]` |

**导航**：`j`/`k`（或方向键序列尾字节 `A`/`B`）上下，`Enter`/空格执行，
`q`/`m` 退出。**换行二义性定案**：紧跟命令字节的换行是尾字节（本项目
`"b\n"` 一行发的习惯），400ms 窗内吞掉；单独敲的回车才当"执行"
（`SysMenu::key()`，`m_lastKeyAt` 基准，CRLF 首字节触发后刷新基准吞第二字节）。
刷屏节奏：开菜单全刷（清残影），导航/动作/关菜单快刷（DTM1 = 屏上真实菜单帧）。

**网页路由**（单 WebServer:80 随 WiFi 开关整体起停）：
`/` 状态索引 · `/wifi` 配置（内含阻塞扫描 1–3s，落在等待窗，翻页顺延）·
`/wifi/save` 存 NVS + 延迟 1.5s 重启（响应先发完）· `/upload` 上传 ·
`/update` 固件 OTA（`Update.begin/write/end`，OTA 关时收到上传直接拒绝不碰 Update）·
`/debug` 调试台（状态/复位面板/日志尾巴，§11）。

**关键机制**：
- **NetSvc::loop() 只在 loop 等待窗被轮询**（5s 分片，20ms 一次）——上传/刷固件的
  闪存写全落在翻页间隙，不打断 e-ink 刷新；`/wifi` 扫描同理（翻页顺延几秒）。
- **STA 15s 连不上自动回落开配置热点**（密码错/路由器不在也救得回来）。
- **深睡前 `net.beforeSleep()`**：停 server/OTA、`WiFi.disconnect(true)` +
  `WIFI_OFF`，半截上传文件删除 —— 深睡不带电（§2）。
- **深睡时菜单开着**（`RTC_DATA_ATTR s_sleepMenu`）：屏上是菜单帧不是书页，
  开盖跳过零闪烁恢复（fbShown 与屏上内容对不上会花），走全刷回书页。
- NVS 独立命名空间 `eink-net`（`wifi`/`ota`/`up`/`ssid`/`pass`），与书进度的
  `eink-book` 不混；WiFi 驱动自身 NVS 关掉（`WiFi.persistent(false)`）防闪存磨损。

**验收**：编译通过（989KB——当时 default 表 1.25MB app 分区 75%；换根目录
`partitions.csv` 3MB 表后 997KB/3MB 仅 32%，见坑 22；OTA app1 够用；
heap 余 244KB，WiFi 栈 ~45KB 无压力）。**硬件实测待做**：热点配网全流程、
上传进书库、arduino-cli 网络上传、开 WiFi 后双屏同刷不重启（§2 电流预案：
若重启 → AMS1117 单独喂屏）。

## 9. 选书主页与按键层级（2026-10-08 新增，src/HomePage.* + src/UiDraw.*）

**需求**：要有一页能"选书"的主页；`Menu` **短按 = Home 键**（回主页）；
**长按 250ms = 阅读菜单**（2026-10-12 前是系统菜单，见 §10）。

**三层页面**（互斥显示，菜单可叠在主页之上，`g_home` 在菜单期间不清）：

| 屏 | 内容 | 进入 | 退出 |
|---|---|---|---|
| 书页 | 当前对页（自动/按键翻页） | 开机、打开选中书 | Menu 短按 → 主页 |
| 主页 | 左页书库列表（`>` + 下划线 + `[在读]`）/ 右页正在读·书库统计·按键说明 | **Menu 短按**（全刷） | Font 短按打开选中书；串口 `n`/`q` 回书页 |
| 阅读菜单 | 本书书签/目录/进度/删书（§10） | **Menu 长按 250ms**（书页，全刷） | Menu 短按 / `q` 回书页 |
| 系统菜单 | §8 四项设置 | **Menu 长按 250ms**（主页里）/ 阅读菜单"系统设置"项 | Menu 短按 / `q` —— 按来源回主页或书页 |

**键位（`eink.ino keyAction()/drainKeys()`）**：
- `Menu`：按下不表态，等 `LONG`（= 系统菜单）或 `RELEASE`（= 主页）分岔 ——
  `RELEASE.longFired` 天然区分短/长按，不必按下就抢开菜单。
  菜单内按 `Menu` 退出发生在 `PRESS`，这次按住余下的 `LONG`/`RELEASE` 由
  `g_menuExitSwallow` 吞掉（否则退出后又立刻开菜单/跳主页）。
- `Prev/Next`：书页 = 翻对页；主页 = 上下选书（同一条并批路径，净位移一次快刷）。
- `Font`：书页 = 短按字号/长按字体家族；主页 = 短按**打开选中书**。
- 选中**正在读的那本** = 只回阅读页（`closeHome()`，进度原地不动）；
  换书 = `openBook()` + NVS 单槽进度覆盖，从第 0 对页起（同串口 `b`）。

**刷屏节奏**：进主页/进菜单/开新书 = 全刷（整屏换内容、清残影），
主页内选书、菜单导航、回书页 = 快刷（DTM1 = 屏上真实上一帧）。

**深睡**：`RTC_DATA_ATTR s_sleepHome` 与 `s_sleepMenu` 同款 —— 睡前屏上是主页，
开盖跳过零闪烁恢复（fbShown 与屏上内容对不上会花），走全刷回主页；书的进度
已按 NVS 恢复，在主页里选中它即接着读。

**排版复用**：菜单/主页共用 `src/UiDraw.*`（`utf8At`/`drawUtf8`/`drawCjkStr`/
`drawBorder`，原 `SysMenu.cpp` 私有函数原样抽出）—— 两页 UI 的坐标、ASCII 11px
/ CJK 16px 步进、`maxX` 截断口径只留一份。版式：标题 20–66、列表 88 起每行 30
（16 本 = 书库容量上限 → 末行 538）、页脚线 566 + 提示 584/610。

**串口**：`n` 进/出主页，主页内 `j`/`k`（或方向尾字节 `A`/`B`）上下、
空格/回车打开、`q` 回书页、`m` 系统菜单、`D` 删除选中书（换行尾字节 400ms 窗同 §8 定案）。

**验收**：编译 997KB/76% 零警告（2026-10-08）。**屏上待验收**：Menu 短按回主页、
长按进菜单、主页选书换书、睡前在主页开盖回主页。

## 10. 阅读功能：书签 / 目录 / 进度% / 删书（2026-10-12 新增）

对标 Kindle 的阅读功能层。数据与 UI 分两层：

**数据层（Book 接口扩展，TxtBook / EpubBook 各自实现）**
- `permille()` 全书进度千分比：TXT = 对页起点字节偏移/文件大小（精确）；
  EPUB = spine 章权重（zip 条目解压尺寸，`EpubZip::forEach` 一次 O(N) 中央
  目录遍历惰性建表，避免 locate_file 线性扫 × N 章的 O(N²) SD 往返）×
  章内偏移/章文本大小比例换算。页眉显示 `p.N · 42%`（TxtBook::makeHeader，
  EPUB 由 `EpubBook::renderPair` 注入全局值，`TxtBook::renderPair` 自行按字节
  算——注意不能经 `permille()` 取，它优先返回注入值会自锁）。
- `tocCount()/tocTitle()/jumpToToc()`：EPUB 解析 OPF 时顺带找目录源——
  EPUB2 NCX（manifest media-type 含 dtbncx）→ `walkNcx` 递归 navPoint
  （navLabel/text + content/src，`#fragment` 截掉后经 `resolveZipPath` 折叠
  匹配 spine 章）；无 NCX 再试 EPUB3 nav.xhtml（properties=nav）→ `walkNav`
  递归 ol/li/a。两者都无 → 退化"第N章"合成目录（tocCount 返回章数）。
  TXT = 启发式扫章：行首 `第X章/回/节/卷/部/篇`（X 限数字与中文数字）、
  `Chapter N`、整行短词（序章/前言/楔子/尾声/后记…，≤78B 行），独立句柄
  流式扫（不碰排版游标），结果缓存片内 LittleFS（键 = 路径 FNV-1a 哈希，
  失效键 = 书文件大小）。主机端验证：26 例标题判定全过；三本书 NCX 匹配
  alice 6/6、carol 24/24 全命中。
- `jumpPermille(p)`：EPUB 按章权重选章（权重 0 的章自然跳过）→ loadChapter
  → 章内偏移 = 目标在章权重区间内的比例 × 章文本大小（TxtBook::seekTo 对准
  UTF-8 边界）；TXT 直接字节偏移。页号按已渲染页平均字节数估算
  （`m_avgNum/m_avgDen`，renderPage 累计）——跳转后页眉 p.N 是估计值，
  % 是精确的，对页对齐（偶数）。

**UI 层（src/ListPage.* 通用滚动列表 + src/Bookmarks.* NVS 书签）**
- ListPage：左页标题+可滚动选中列表（>16 项滚窗，版式同主页），右页
  "当前"信息 + "操作"说明（支持按项两行 hints）；`menuList` = 阅读菜单
  （7 项：添加书签/书签列表/目录跳转/跳到进度/删除本书/系统设置/返回），
  `subList` = 子列表（书签/目录/进度三选一，`g_subMode` 区分），可叠放。
- 书签 = `BmLoc{off,page,ch,permille}`，坐标语义与进度存档/对页历史栈
  一致（`restoreAt` 直接可用）；NVS "eink-book" 空间 blob 存储
  （key = `bm`+FNV-1a(路径)，每书 16 条上限，192B）——选 NVS 是因为坑 18
  定案 SD 写入物理锁卡，书签这种高频小写绝不碰 SD。
- 键位变更（WIRING §3.4 已同步）：**书页 Menu 长按 = 阅读菜单**（原系统菜
  单挪到主页长按 + 阅读菜单"系统设置"项）；**主页 Font 长按 = 删除选中书**
  （确认屏：Font 短按 = 确认 / 其他任何键 = 取消）；阅读菜单/子列表内
  Prev/Next 选择、Font 短按执行、Menu 退出。跳转（书签/目录/进度）前把
  当前对页压历史栈 → Prev 可一步步跳回跳转前位置。
- 串口：`M` 阅读菜单、`k` 直接加书签、`t`/`T` 直达目录/进度（不开菜单）、
  `D` 删当前书（确认屏 `y`/空格确认）。
- 深睡：屏上非书页（阅读菜单/子列表/确认屏）与系统菜单同记账
  （`s_sleepMenu`），开盖走全刷回书页。
- 删书内核 `removeBookByPath`（按键确认屏与网页 /library/del 共用）：
  清 NVS 书签 + 指向本书的单槽进度 → SD remove → 重扫 → 删的是在读那本
  则顺位开下一本可读的书（从第 0 对页起）。

**网页（NetSvc 扩展，与 /upload 共用"电子书上传服务"开关）**
- `/library`：书库列表（大小/SD 用量）+ 每本 **下载**（streamFile，
  filename* UTF-8）/ **删除**（JS confirm + XHR POST → `onBookRemoved`
  回调走删书内核）。
- `/upload` 与 `/update` 表单改 **XHR 上传 + 实时进度条**（原生 form POST
  浏览器只给转圈）：百分比 / 已传 MB / 速率；服务端 512B 单块写与 OTA 流程
  不变。

**验收**：编译 1022KB/3MB（32%）零警告；标题判定 26 例主机端全过；
NCX 匹配主机端镜像验证全命中；rot_layout_test 离屏回归通过。
**屏上待验收**：阅读菜单四项全流程、书签跳回、TXT 目录扫描耗时与命中率、
EPUB 章权重建表的开书耗时、网页 /library 删书与下载、上传进度条、
跳转后 Prev 回退、深睡时开着阅读菜单开盖恢复。

## 11. 网页调试台 /debug + 面板降级（2026-10-12 新增，src/DbgLog.*）

**需求**：现场"左屏没有响应，网页都打不开了"——根因是 `setup()` 里
`left.begin()` 失败走 `while(1) delay(1000)` FATAL 卡死：loop 永不运行 →
`net.loop()`（handleClient）永不轮询 → WebServer 接受了连接也永远不应答。
屏幕一挂，唯一线索只剩串口。**原则：屏幕是外设不是命门** —— 任何一块屏
（甚至两块全）挂掉，WiFi/OTA/网页/串口必须全部照常活着。

**面板降级（eink.ino）**：
- 开机：`left.begin()`/`right.begin()` 结果分别记 `g_leftOk`/`g_rightOk`，
  不再有任何 FATAL 卡死路径（framebuffer 分配失败除外——没显存什么都画不了）。
  失败组合：单左 / 单右 / **无头** 三种退化模式，刷新路径只碰活着的屏。
- 运行期：连续 `PANEL_STRIKES=3` 次 BUSY 超时且探针（`idle()`）显示该屏
  BUSY 仍没拉高 → 判死降级（`strikePanel()`），从刷新路径摘出去；成功刷新
  即清零计数（瞬态干扰不冤枉屏）。两屏都死 → 无头模式，刷新不再碰 SPI，
  也就不再每轮白烧 8s 超时。
- **无头救砖通道**：两屏都挂时 `net.startPortal()` 自动开配置热点（屏幕菜单
  已经全没了，这是唯一入口）——手机连上 `eink-book-xxxx` 热点开
  `http://192.168.4.1/debug` 即可远程诊断。会把 `wifi` NVS 置开（救砖场景
  可接受，正常路径不触发）。

**串口日志镜像（src/DbgLog.h/.cpp）**：`#define Serial DbgSerial` 宏重定向 ——
include "DbgLog.h"（各 .cpp 放**最后一条 include**，库头先展开，库自己的 .cpp
是独立编译单元不经宏）之后，本编译单元所有 `Serial.*` 走 `DbgSerialProxy`：
一份原样转发真 UART0（本地串口照旧），一份带 `[ms]` 行时间戳进 **PSRAM 32KB
环形缓冲**。`DbgLog.cpp` 在宏生效前抓 `&Serial` 指针，转发不自递归。`if
(Serial)` 恒真、`available/read/peek/flush` 直通 —— 收割验证等读口行为不变。

**网页路由（NetSvc 扩展，不挂任何服务开关——WiFi 开着就能用）**：
- `/debug`：设备（运行时长 / **复位原因**（崩溃还是上电一眼定位）/ 固件编译
  时间戳 / heap+最低水位 / PSRAM / WiFi+RSSI）、屏幕（模式 / 左右 BUSY 电平 /
  存活状态 / 上次刷新耗时 / fast+full 统计）、存储（SD 用量 / 书库 / 在读页与
  进度%）、按键（去抖丢弃 / 队列溢出）+ 动作按钮：**复位左/右屏**（`begin()`
  重 init + 硬复位，RST 脉冲救卡在 BUSY 的屏）/ **重画当前屏**（按 UI 上下文
  分发，不顶掉菜单帧）/ **上·下一对页** / **重启设备**。
- `/debug/log?since=N`：日志环增量（text/plain 原样字节，客户端 textContent
  追加不转义；单次 ≤8KB 头裁 + "已滚出"标记；游标 = 累计字节数，响应头
  `X-Seq` 回执；页面 2s 轮询 = 远程实时串口尾巴）。
- `/debug/act`（POST a=resetL|resetR|refresh|flip|flipback|reboot）：
  302 回 /debug；reboot 走既有 `m_restartAt` 延迟重启（响应先发完）。
- 设备侧状态一律经 `net.onDbgInfo` 回调从 eink.ino 注入（NetSvc 不猜硬件），
  动作回调与 `onBookAdded` 同在 loop 等待窗上下文执行，可以安全刷屏。

**验收**：编译 1033KB/3MB（32%）零警告。**屏上/网页待验收**：拔左屏上电
→ 进单右屏模式且热点/网页可达；/debug 显示 BUSY 电平与复位原因；复位面板
按钮救回卡 BUSY 的屏；/debug/log 与本地串口内容一致；两屏全拔 → 自动热点
救砖通道可达。

## 12. 漫画对页排版（2026-10-13 新增，src/EpubBook.* + src/TxtBook.cpp + tools/pair_manga_epub.py）

双屏对折硬件的一屏 = 左右两个面板各一页；漫画 EPUB（calibre 转换器产出）每章
只有一张整页扫描图，直接读时一章只够画左面板，右面板只剩"页眉+页码"的空白页
（章尾残留空行也被渲成一页）。要让一屏对页 = 漫画两页，需要书侧和固件侧配套：

**书侧**（`tools/pair_manga_epub.py`，批量同一条命令）：spine 里连续的单图章
（恰好 1 张 img、无正文、非 svg 封面）两两合并为一个 XHTML——同一 `<p>` 内两张
`<img>` 单个空格分隔。合并后一章的文本流 = `[[img:A]] [[img:B]]␣\n`，两张整页图
正好连续落满左右面板。奇数尾巴单图章保留（结尾右面板空白一页，符合书籍装帧）。

**固件侧**（三处小改，旧书行为不退化）：
1. `EpubBook::emitImageMarker` 图标记分隔 nl()→前 sep()/后空格：行首的图仍独占
   行首；行内相邻图标记用空格接排。换行会先占一个空行，整页图（33 行占满）被
   挤到下一页 → 左右配对错位（这正是初版"只改书不改固件"失败的原因）。
   空格必须 put() 直写——走 text() 会被 pendingSpace 机制吞掉。
2. `TxtBook::renderPage` 无内容页判定（s_hadContent）：EPUB（m_loop=false）一页
   只有空行/直接 EOF 时返回 false。纯空白页不再占用面板画"有页码的空白页"，
   交给 `EpubBook::renderPair` 的跳过/跳章逻辑（漫画章尾 `␣\n` 残留即此路径）。
   TXT（m_loop=true）语义不变。s_hadContent 在 flushLine 画掉非空行、
   placeImageBlock 图块占位时置位。
3. `EpubBook::renderPair` 左页跳过循环加 guard 封顶（≤章数）：配合 2，整书空白章
   时绝不死循环。

**整页图几何**：扫描页 ~667×1024，面板正文 464×598px → 按宽贴满自然高 ~712px
> 一页，页首硬压进 33 行（等比缩至 464×594 居中，两侧留白；与 P4 单图章同路径，
宽高比不变）。合并章内第一张图在左面板页首、第二张在右面板页首，都走硬压分支。

**验收**（2026-10-13）：编译 1033KB/3MB 零警告；Python 仿真全书 96 对页面板序列
（tools/pair_manga_epub.py 的文本流 + TxtBook 分页规则复刻）：93 合并章全部
img|img 满对，仅封面右页与奇数尾页右页共 2 张空白页，符合预期。
**屏上待验收**：合并后的漫画 EPUB 左右配对、翻页连续、章末不卡。

## 13. 双核章节缓存：跨章翻页毫秒级（2026-10-13 新增，src/EpubBook.* + src/EpubZip.* + src/DbgLog.cpp）

**问题（坑 23）**：EPUB 一章一转换 = zip 解压 + tinyxml2 整章 DOM + LittleFS 落盘，
大章节几秒到十几秒。落在跨章翻页/回退的按键路径上 = 可感知卡顿（TXT 只 seek 故无感）。
2026-10-13 先修掉同章回退无条件重载（`restorePair` 仅跨章才 `loadChapter`，commit
b60ebb0），跨章的转换成本本体由本节缓存消化。

**定案**：core0 预取任务（`epubpf`，8KB 栈，优先级 1）把**当前章前后各一章**提前
转换进 **3 个 LittleFS 槽位**（`/__s0..2.txt`，≤444KB×3≈1.3MB，9.9MB spiffs 分区
无压力）轮换；主核 `loadChapter` 命中 READY 槽 = 打开文件（毫秒级），未命中才走
原同步路径（行为同无缓存）。这是 §7 讨论的落地，但切口比"整页预取"更保守：
**缓存单元 = 转换后的章文本**，不碰 Paint/帧缓冲/单写者约束，字号切换无需作废。

**槽位状态机**（`s_mu` 保护）：IDLE→WRITING→READY。
- WRITING 绝不驱逐：恰是目标章就等它就绪（翻章撞预取最常见），否则等落定再重选；
- 当前章槽（m_txt 正开着）绝不驱逐/复用；
- 无 IDLE 时驱逐"离目标章最远"的 READY 槽（持续前进/后退时缓存始终指着行进方向）；
- 换书/关闭 = 代际 m_gen 自增 + 清槽，在飞预取单经 (gen,slot,ch) 三重校验自然作废；
- 半成品文件由复用方 FILE_WRITE 截断覆盖，无需清理协议。

**预取任务体**（`pfConvert`）：独立 `EpubZip` 实例（miniz 流 per-instance）+
`extractToBuffer`（新：块回调累积进 PSRAM 增长缓冲，≤2MB 上限——实测有书单章
1.2MB，1MB 会整章放弃；免临时文件、不与主核 `__e.xhtml` 撞名竞争）→ BOM/实体
预处理 → tinyxml2 解析 → TextSink 写槽位。
SD 读失败**不自救**（Storage::recover 是全局操作，留给主核同步路径统一处理），
本单作废即可；解析失败同理（不做剥标签兜底——那是主核路径的降级）。

**SD 串行 = s_sdMu 递归互斥**：ESP-IDF 4.4 的 SDMMC 卡命令路径没有会话锁，双核
并发戳卡会互踩命令。所有 zip/SD 访问持锁：extractWithRecovery（含自救）、
ensureChSizes 的 forEach、open() 全程、预取解压。LittleFS/PSRAM 分配器自身线程
安全，不加锁（core0 写 flash 的关 cache 窗口只带来毫秒级抖动）。

**门控**（任一命中则不预取，翻章退回同步路径）：WiFi 开（core1 可能在服务网页
读 SD）、CJK 字库流式模式（渲染期也在读 SD）。DbgLog 环形缓冲加 portMUX
临界区（原来无锁，双核并发打日志会互踩）。

**观测点**：`[epub] prefetch chN -> slotM ok (xxx ms)`（core0 完成）、
`[epub] load chN slotM (xxx ms)`（主核，命中应 ≈ 开文件时间）、
`[epub] chN cache wait xxx ms`（撞预取等待）。`[epub] chapter: ... psram free=`
照常打，盯大章节转换时 PSRAM 余量（unifont 2MB + DOM 峰值 + 渲染缓冲共存）。

**验收状态**：编译零警告 ✅；2026-10-14 实机定论——"开机卡住"实为**开机恢复到
1.2MB 单章 XHTML 的阅读位置**（解压 17.6s + DOM 解析更久，全程几十秒无输出，
旧固件同路径同慢，非本缓存引入）；b60ebb0 A/B 对照开机正常（该书 ch0 是 250B
封面，不代表整书快）。硬件/SD/双核并发全部排除嫌疑。屏上待验收：跨章翻页命中
缓存（`load chN slotM (毫秒级)`）与 WiFi 开关门控。
