RobaLinan/dual-ink-reader/BOM.md

# 备料清单（BOM）· 双屏电子书 v4 —— P6 装配

> 用途：**P6 = 3D 打印底板 + 铰链 + 10 芯排线 + 板载按键 + 4 键逻辑 + 电池包深睡验证**
> （验收：合盖能翻页、单手可持、连续翻页无复位、**深睡不被电池包自动关机**）。
> 依据：DESIGN.md §1.6 / §4-P6、WIRING.md §3（连接器明细）、方案 §1.4（电源硬指标）。
> 状态：✅ 手上已有 · ❓ 待确认库存 · 🔲 待买 · ⚙️ 自制 · ⚠️ 选型有硬指标
> 2026-09-28 建 · 同日按实际库存校正（esp32s3 / 屏+转接板 / SD 模块 / 霍尔模块 /
> 静音微动开关 / 可穿线阻尼铰链 / M5×3 磁铁 / 常用电阻电容 均已有）。

## 1. 电源（最高优先级：选错直接报废一个功能）

| 状态 | 物料 | 规格 | 数 | 用途/备注 |
|---|---|---|---|---|
| ⚠️ 🔲 | **5V 充电电池包** | ≈3000mAh，**必须无自动关机 / 支持常开** | 1 | 直供开发板 5V/VIN（方案 §1.4 硬指标①）。普通充电宝在几十 µA 深睡电流下会自关 → 合盖深睡后唤不醒，功能直接报废 |
| 🔲 | AMS1117-3.3 模块 | 成品小板 | 1 | **仅回退方案**：双屏重叠刷新尖峰（300–400mA）若顶垮板上 LDO 重启才用。原理图已放 **Ams1117** 位（R12/R13 0Ω 链接，**默认 DNP**，WIRING §3.8）。⚠️ 静态 ~5mA，**不可当主 LDO**（深睡要 µA 级） |
| ❓ | 电解电容 | 100µF / 25V | 2 | 每屏 VCI 就近去耦（WIRING §4 制板 checklist 第 1 条）——常用件里若有直插 100µF 即免买 |
| ❓ | 电解电容 | 1000µF / 16V | 1 | 双屏刷新尖峰预案的大电容（先备着，P2 用不上就留作电池端缓冲） |
| ✅ | 陶瓷电容 | 100nF、10µF | — | 屏 VCI/SD 座旁去耦（SD 座 10µF+100nF）、DRV5032 板载（常用电容已有） |
| ✅ | 电阻 | 47kΩ ×2 | — | SD CMD/D0 上拉→3V3（`0x107` 教训，SD 规范 10–100k；常用电阻已有） |
| ✅ | 电阻 | 10kΩ ×3 | — | SD DAT1/2/3 上拉→3V3（坑 18 复测：上拉后写路径转稳；**经电阻勿直连**，WIRING §1/§3.3） |
| ✅ | 电阻 | 0Ω ×3 | 3 | R12/R13（Ams1117 的 5V/3V3 链接，**默认 DNP**）、R14（Pow 入口）。可贴 0Ω 或直接短接 |
| ⛔ | 电阻 | 100kΩ ×2 | — | 电量检测分压（GPIO8）——**原理图已删除该段**（BAT_SENSE），暂不需要；日后恢复再加（WIRING §3.6） |

**电池包到货必测（早买早测，不通过就退换）**：
1. 拆规格书看有无"自动断电/低电流关机"字样，或直接实测；
2. 实测：接板拉 **50–100mA 负载 → 深睡态（几十 µA）保持 ≥10min** → 恢复负载后仍输出 = 常开合格；
3. 合格判据 = P6 验收后半条：合盖深睡 10 分钟，开盖能唤醒。

## 2. 互连（J3 铰链排线是 P6 的关键件）

| 状态 | 物料 | 规格 | 数 | 用途/备注 |
|---|---|---|---|---|
| 🔲 | **10 芯排线 + IDC10 压接头** | 灰排线 1.27mm，长度 ≈12–15cm（含弯折余量） | 1 套 | **J3 铰链线**（WIRING §3.2 芯序：3V3/GND/SCK/GND/MOSI/GND + R_CS/DC/RST/R_BUSY）。地芯贴时钟/数据芯；3V3+GND 芯用满线径（单屏峰值 ~200mA）。也可用 10 芯彩排线手焊省掉压接工具 |
| — | 2P 线 ×4 | 若按键不在板上，由 Btn_* 引出（板上已是 10k↑ 信号脚） | 4 | **按键不再有小板**：4 个开关直接放主板（见 §3）；仅当按键要外置时才需引线 |
| 🔲 | 3P 飞线 | 长 ≈5cm | 1 | **Hall 霍尔**（飞线；芯序 1=GND/2=3V3/3=OUT，WIRING §3.5） |
| 🔲 | 3P 飞线 | 长 ≈5cm | 1 | **Ams1117 模块**（仅回退时接；另见 §1） |
| 🔲 | 2P 线 + 插头 | 按电池包输出口选（DC2.1/PH2.0/裸线） | 1 | **Pow 电池输入** |
| 🔲 | 杜邦线/硅胶线 | 26–28AWG | 若干 | 屏 L/R 转接板、杂项；**SPI 10MHz 走线尽量短**，>15cm 再考虑 22Ω 串阻（先 DNP） |

> 屏 SCK/MOSI 两屏并联（WIRING §3.1）：右屏信号全部经 J3，所以排线里必须有
> SCK+MOSI+R 侧 4 根控制 + 3V3 + 3 根地。

## 3. 按键（主板侧，⚙️ 无独立小板）

按键与主控同板（原理图 Btn_Prev/Btn_Next/Btn_Menu/Btn_Font，2P 端子 KF301-5.0-2P），**10k 上拉在主板侧**：

| 状态 | 物料 | 规格 | 数 | 备注 |
|---|---|---|---|---|
| ✅ | **静音微动开关** | 手上已有 | 4 | PREV/NEXT/MENU/FONT；低有效。静音手感正合阅读器，免买轻触开关 |
| ✅ | 电阻 | 10kΩ ×4 | 4 | **上拉在主板侧**（R6–R9），3V3→GPIO1/2/9/10；信号取上拉脚、另一端接 GND（WIRING §3.4） |
| — | GPIO 备注 | GPIO **1/2/9/10 全是 RTC IO** | — | 与霍尔共用 ext1 唤醒；**4 键逻辑代码自 P3 挪入 P6**（DESIGN §4-P6），接好线后才写 |

## 4. 结构件

| 状态 | 物料 | 规格 | 数 | 备注 |
|---|---|---|---|---|
| ❓⚙️ | **3D 打印底板 ×2** | 展开 176×119mm、合起 98×129mm、单页区 88.2×118.8mm（≈A6）；2–3mm 厚 + 加强筋 | 2 | 左半：屏L+转接板、S3 开发板、SD、按键（板上 Btn_*）、霍尔；右半：屏R+转接板、磁铁。⚠️ **仓库里还没有模型文件**（无 stl/scad）→ 建模是 P6 第一件事，转接板排针高度给线槽留空间 |
| ✅ | **可穿线阻尼铰链** | 手上已有（免布基胶带起步方案） | 1 | ⚠️ 装配前核**过线孔径/线槽**能否容下 J3 的 10 芯排线 + 弯折半径；不够则按 WIRING §3.2 备注把 4 或 6 的 GND 改 NC 降芯数，或拆两束分走 |
| ✅ | **磁铁 M5×3** | ⌀5×3mm | ≥1 | 现有库存即用；与 DRV5032 对位/气隙是坑 20 的硬件排查项（全极性开关型单颗即可触发） |
| ✅ | DRV5032 模块 | 全极性开关型 | 1 | P3 已实测；3V3 常供电勿切电（WIRING §3.5） |
| ❓ | 固定辅料 | M2/M2.5 螺丝+铜柱、双面胶、硅胶垫、扎带 | — | 屏转接板/开发板/电池包固定；电池建议嵌**脊部**附近（重量均衡，方案 §1.6） |
| ❓ | 打印耗材 | PLA/PETG（有打印机则查库存） | — | 铰链已有，耗材只用于底板两半 |

## 5. ✅ 已有（不用买，装配时直接上）

屏 GDEY0583T81 带转接板 ×2 · ESP32-S3 DevKitC-1（N16R8）· microSD 模块/卡 ·
DRV5032 霍尔模块 · **静音微动开关 ×4** · **可穿线阻尼铰链** · **磁铁 M5×3** ·
常用电阻（10k/47k/100k）与常用电容（100nF/10µF）· USB-UART 小板 · 面包板与杜邦线。

## 6. 下单后 → 装配 → 验收 checklist

- [ ] **电池包常开实测通过**（§1 三步；不通过先退换，别急着装配）
- [ ] 铰链过线核对：10 芯排线能穿过 + 弯折半径够（不够按 WIRING §3.2 降芯/分束）
- [ ] J3 排线通断/芯序对表（WIRING §3.2）；装上后刷 100 次（每 5 快 1 全）无花屏无复位
- [x] 按键 Btn_* 上拉在主板侧（R6–R9）；信号取上拉脚、另一端接 GND —— 2026-10-08 `key_test/` 电气实测通过（空闲全高/4 键各 10 次不漏/无连锡）
- [x] 4 键 ext1 唤醒 —— **2026-10-08 定案不做**：只有霍尔参与 EXT1 唤醒，按键不唤醒（无极性冲突，见 WIRING §3.4）
- [x] 4 键翻页/菜单/字号代码（P6 任务）—— 2026-10-08 落地（`src/Keys.*` + `eink.ino`，编译 993KB/75%）
- [ ] 4 键屏上验收：翻页/回退/菜单内导航/字号与家族切换 + 连按 100 页无复位（并入 P6 验收）
- [ ] 屏 VCI、霍尔 3V3 深睡不断电（WIRING §4 第 5 条）
- [ ] SD 上拉/去耦已焊：CMD/D0 各 47kΩ、DAT1/2/3 各 10kΩ（**勿直连 3V3**）、SDCard VDD 就近 10µF+100nF（写路径硬件收尾，做完把 §5.7 待补项一起清掉）
- [ ] 底板装配：单手可持、合盖能翻页、连续翻页无复位 → **P6 验收**
- [ ] 合盖深睡 ≥10min → 开盖唤醒成功 → 电池包硬指标闭环
