RobaLinan/dual-ink-reader/CAD/print_profile.3mf

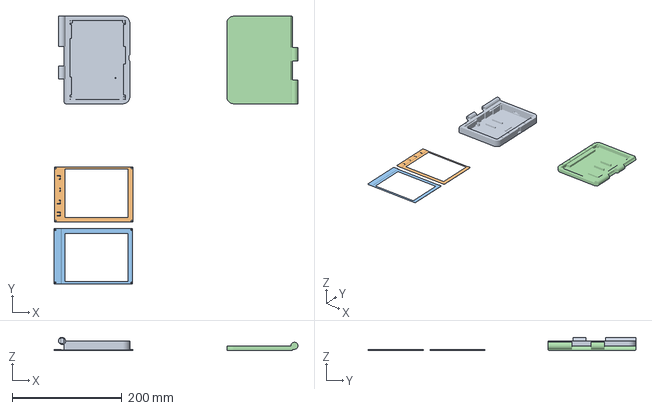
[picture p3: CAD file, 2026-10-14]
CAD/print_profile.3mf
445.6 x 488.8 x 24.5 mm
