RobaLinan/dual-ink-reader/CAD/E-book.FCStd

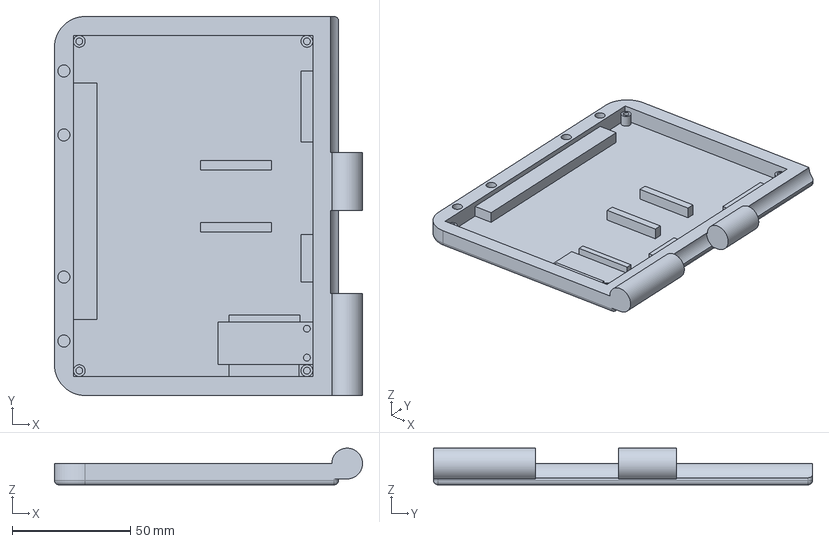
[picture p4: CAD file, 2026-10-14]
CAD/E-book.FCStd
130.1 x 160.0 x 15.5 mm
