RobaLinan/dual-ink-reader/CAD/3D_PCB1_2026-10-01.step

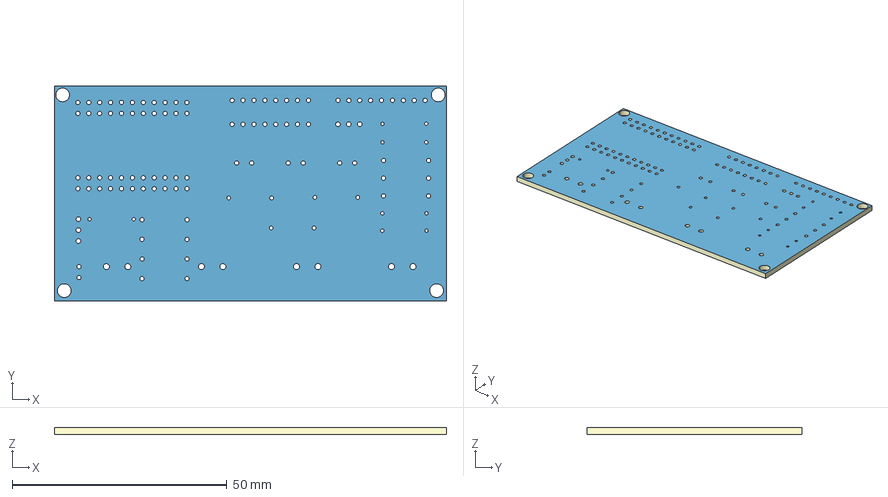
[picture p5: CAD file, 2026-10-09]
CAD/3D_PCB1_2026-10-01.step
91.3 x 50.0 x 1.60 mm
Board~Zi7J
TopCopper~Zi7J
BottomCopper~Zi7J
TopSilkscreen~Zi7J
BottomSilkscreen~Zi7J
TopFpcStiffener~Zi7J
BottomFpcStiffener~Zi7J
