RobaLinan/dual-ink-reader/CAD/cl8006.FCStd

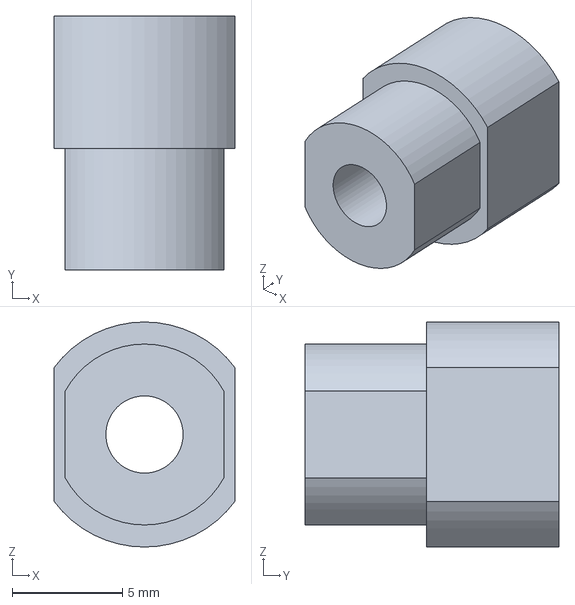
[picture p6: CAD file, 2026-09-30]
CAD/cl8006.FCStd
8.20 x 11.5 x 10.2 mm
