RobaLinan/dual-ink-reader/WIRING.md

# 接线表（PCB 制图用）· 双屏电子书 v4

> 依据：DESIGN.md §1.1、`eink.ino` 引脚宏、`src/Storage.cpp` SDMMC 定案（2026-09-24 核对）。
> 主控 ESP32-S3 N16R8；**全部信号 3.3V 电平**；屏 SPI = 10 MHz / MODE0 / MSBFIRST，SDMMC 1-bit @20 MHz。
> ⚠️ 屏/SD/霍尔已实测（霍尔深睡随 P3 收官，2026-09-24）；**按键电气已实测**
> （2026-10-08 `key_test/` 台架：空闲全高、4 键各 10 次不漏不错位、去抖零毛刺、
> 组合键无连锡、静置 80s 电平稳定）——**唤醒定案（2026-10-08）：只有霍尔
> 参与 EXT1 唤醒，按键不唤醒**（阅读流 = 合盖睡/开盖醒 → 按键翻页，无需
> 按键叫醒设备），故 EXT1 保持 `ANY_HIGH` 单极性不动，无极性冲突。
> **4 键功能已落地**（`src/Keys.*` + `eink.ino`，键位表见 §3.4）——屏上验收待做。
> 2026-09-29 更新（原理图 `PCB/double_eink_reader.eprj2`，EasyEDA Pro；位号已改为功能名）：
> - 按键**无独立小板**，与主控同板（Btn_Prev/Next/Menu/Font，上拉 R6–R9 在主板侧）；
> - 霍尔 **Hall**、microSD **SDCard** 均为**飞线**，芯序以本表为准；
> - **BAT_SENSE 电量检测已从原理图删除**（GPIO8 空出，可作后用）；
> - 新增 **Ams1117**（AMS1117-3.3 回退模块，R12/R13 0Ω 链接）与电源入口 **R14** 0Ω。

## 1. GPIO 总表

| GPIO | 网络名 | 方向 | 对端 | 备注 |
|---|---|---|---|---|
| 12 | EPD_SCK | 出 | 屏L CLK + 屏R CLK | 两屏并联（SPI2） |
| 11 | EPD_MOSI | 出 | 屏L DIN + 屏R DIN | 两屏并联 |
| 14 | EPD_L_CS | 出 | 屏L CS | 低有效，选片→传输→释放 |
| 15 | EPD_L_DC | 出 | 屏L D/C | |
| 16 | EPD_L_RST | 出 | 屏L RES | 低有效 | 
| 17 | EPD_L_BUSY | 入 | 屏L BUSY | **高 = 空闲**（此模组极性） |
| 18 | EPD_R_CS | 出 | 屏R CS | 经铰链排线 J3 |
| 21 | EPD_R_DC | 出 | 屏R D/C | 经 J3 |
| 47 | EPD_R_RST | 出 | 屏R RES | 经 J3 |
| 48 | EPD_R_BUSY | 入 | 屏R BUSY | 经 J3；DevKitC-1 与 RGB LED 同脚，刷新时 LED 闪属正常 |
| 38 | SD_CLK | 出 | SD CLK | SDMMC 1-bit，不需要上拉 |
| 39 | SD_CMD | 双向 | SD CMD | **47kΩ↑→3V3**（SD 规范 10–100k；固件内部上拉只是兜底，0x107 教训） |
| 40 | SD_D0 | 双向 | SD DAT0 | **47kΩ↑→3V3**，同上 |
| — | SD_DAT1/2/3 | — | 不接（SDCard 侧各自 10kΩ↑→3V3） | 1-bit 用不到；09-28 实测上拉后写路径转稳。**经电阻，勿直连 3V3**（4-bit/卡测试模式会与卡输出对撞） |
| 1 | BTN_PREV | 入 | Btn_Prev（主板） | 低有效，内部上拉 + 主板 10k（R6）；**不参与唤醒** |
| 2 | BTN_NEXT | 入 | Btn_Next（主板） | 同上（R7） |
| 9 | BTN_MENU | 入 | Btn_Menu（主板） | 同上（R8） |
| 10 | BTN_FONT | 入 | Btn_Font（主板） | 同上（R9） |
| 4 | HALL_IN | 入 | DRV5032 OUT（Hall，飞线） | 推挽输出无上拉，ext1 唤醒 |
| 8 | — | — | 空出（备用） | 原 BAT_SENSE 电量检测已从原理图删除；若要恢复：5V—100k—GPIO8—100k—GND，软件滤波（不加电容） |
| 5 / 6 / 7 / 8 / 41 / 42 / 13 | — | — | 备用 | 可作 SD_CD、状态 LED 等 |

## 2. 禁用引脚（封装上凡涉及一律 NC）

| GPIO | 原因 |
|---|---|
| 0 | strapping，仅可接 BOOT 键到 GND，勿接其它外设 |
| 3 / 45 / 46 | strapping，悬空或保持默认 |
| 19 / 20 | USB D−/D+，只连 Type-C 座，否则留空 |
| 26–32 | N16R8 **内部 Flash 占死**（P3 教训：CMD 误接 29 → 0x107 卡无应答） |
| 33–37 | 八线 OPI PSRAM 占用 |
| 43 / 44 | UART0 TX/RX，只作调试串口引出，勿作 GPIO |

## 3. 连接器明细

> 原理图位号（`PCB/double_eink_reader.eprj2`，EasyEDA Pro；已改为功能名）：Pow 5V 输入 / EinkLeft 屏L / EinkRight 屏R / SDCard microSD（飞线）/ Hall 霍尔（飞线）/ Btn_Prev–Btn_Font 按键 / Ams1117 3V3 回退模块。下表 §3.1/§3.2 沿用 J1/J2/J3 旧编号，§3.3 起用原理图位号。

### 3.1 J1 左屏 / J2 右屏 —— GDEY0583T81 转接板（8 针；原理图 EinkLeft / EinkRight）

芯序以转接板**丝印**为准，下表锁信号不锁物理顺序：

| 转接板信号 | 网络 | J1 左屏 | J2 右屏 |
|---|---|---|---|
| VCC (VCI) | 3V3 | 3V3，**就近 100µF + 100nF** | 3V3（经 J3 供电），同样去耦 |
| GND | GND | GND | GND |
| CLK | EPD_SCK | GPIO12 | GPIO12 |
| DIN | EPD_MOSI | GPIO11 | GPIO11 |
| CS | EPD_CS | GPIO14 | GPIO18 |
| D/C | EPD_DC | GPIO15 | GPIO21 |
| RST | EPD_RST | GPIO16 | GPIO47 |
| BUSY | EPD_BUSY | GPIO17 | GPIO48 |

- 右屏**物理旋转 180° 安装**，镜像由固件 `mirrored=true` 处理。
- 深睡时屏 VCI **保持供电**（DSLP ≈1µA），唤醒直接差分刷新——不要加受控断电开关。

### 3.2 J3 铰链 10 芯排线（左半主板 ↔ 右屏转接板）

| 芯 | 网络 | 芯 | 网络 |
|---|---|---|---|
| 1 | 3V3 | 6 | GND |
| 2 | GND | 7 | EPD_R_CS (GPIO18) |
| 3 | EPD_SCK (GPIO12) | 8 | EPD_R_DC (GPIO21) |
| 4 | GND | 9 | EPD_R_RST (GPIO47) |
| 5 | EPD_MOSI (GPIO11) | 10 | EPD_R_BUSY (GPIO48) |

- 地芯贴时钟/数据芯（串扰考虑）；如更需备用芯，把 4 或 6 的 GND 改 NC。
- 单屏刷新峰值约 200mA 经此线，3V3/GND 用满线径。

### 3.3 SDCard microSD（飞线 9P，芯序以本表为准）

| 芯 | 网络 | 主控 | 备注 |
|---|---|---|---|
| 1 | NC | — | 不接（卡座 CD 未引出） |
| 2 | DAT3 | — | 10kΩ↑→3V3（R5）；1-bit 不用 |
| 3 | DAT2 | — | 10kΩ↑→3V3（R4）；1-bit 不用 |
| 4 | DAT1 | — | 10kΩ↑→3V3（R3）；1-bit 不用 |
| 5 | SD_CLK | 38 | 无需上拉 |
| 6 | SD_CMD | 39 | **47kΩ↑→3V3**（R2） |
| 7 | SD_D0 | 40 | **47kΩ↑→3V3**（R1） |
| 8 | GND | — | |
| 9 | 3V3 | — | 卡是 3.3V 器件，**严禁 5V**；就近 10µF + 100nF |

- DAT1/2/3 **必须串 10kΩ 再上拉，禁止直连 3V3**（4-bit/卡测试模式会与卡输出对撞）；09-28 实测上拉后写路径转稳。
- DAT1/2/3 与芯 2/3/4 的对应以实物模块丝印为准（1-bit 下三者都只是上拉，接错不影响功能）。
- CD（卡检测）不在 SDCard 引出，固件不用。

### 3.4 Btn_Prev–Btn_Font 按键（主板板载，无独立小板）

4 个按键位直接在主板上（原理图 Btn_Prev/Btn_Next/Btn_Menu/Btn_Font，2P 端子 KF301-5.0-2P），**10k 上拉在主板侧**：

| 位号 | 网络 | 主控 | 上拉 |
|---|---|---|---|
| Btn_Prev | BTN_PREV | GPIO1 | R6 10kΩ↑→3V3 |
| Btn_Next | BTN_NEXT | GPIO2 | R7 10kΩ↑→3V3 |
| Btn_Menu | BTN_MENU | GPIO9 | R8 10kΩ↑→3V3 |
| Btn_Font | BTN_FONT | GPIO10 | R9 10kΩ↑→3V3 |

- 每个按键：**信号脚 = 带上拉的那一端**，另一端接 GND；按下把信号拉低（低有效）。
- GPIO 1/2/9/10 本身是 RTC IO（继承布线），但**唤醒只走霍尔**（2026-10-08 定案）。
- **键位功能（P6 固件，2026-10-08 落地；P7 主页分层；2026-10-12 阅读菜单）**：
  | 键 | 书页 | 主页（选书，DESIGN §9） | 阅读菜单/子列表 | 系统菜单内 |
  |---|---|---|---|---|
  | Btn_Prev | 上一对页（长按 250ms 后 300ms 连发） | 上一本（连发=滚动） | 上一项（连发=滚动） | 上一项（连发=滚动） |
  | Btn_Next | 下一对页（同上连发） | 下一本（同上） | 下一项（连发=滚动） | 下一项（连发=滚动） |
  | Btn_Menu | **短按 = 主页（全刷）；长按 250ms = 阅读菜单（书签/目录/进度/删书）** | 短按 = 已在主页；长按 = 系统菜单 | 退出（回上一层） | 退出（按来源回主页/书页） |
  | Btn_Font | 短按 = 字号 16/24/32；长按 = 字体家族 | 短按 = 打开选中书；**长按 = 删除选中书（确认屏）** | 短按 = 执行（跳回/跳章/跳进度） | 短按 = 执行当前项 |
  - 删除确认屏（顶层）：Font 短按 = 确认，其他任何键 = 取消。
  - Menu 按下不表态，等 `LONG`/`RELEASE` 分岔（`RELEASE.longFired` 区分短/长按）。
  - 事件入口 `src/Keys.*`，分发/并批 `eink.ino drainKeys()/keyAction()`；自动翻页**默认关**（串口 `a` 开）；串口 `n` = 主页（同 Menu 短按）。
- ⚠️ 2026-09-29 修正并已复核：BTN_* 标签曾误接在 GND 那一脚，现接在**带上拉的信号脚**（否则按键永久读低）。
- ✅ **电气实测通过（2026-10-08，`key_test/` 台架）**：上电空闲 4 脚全高
  （误标 GND 坑已排除）、每键 10 次连按计数 10/10/10/10 不漏不错位、
  `bnc=0`（20ms 去抖窗口零毛刺，最短按住 115ms 正常识别）、2/3/4 键
  组合全部正确识别且各键计数同步 +1（无连锡）、静置 80s 电平恒高。
  长按实测 115–800ms → 后续 4 键逻辑短按阈值建议 ~250ms。
- ✅ **唤醒定案（2026-10-08）：按键不参与 EXT1 唤醒，只有霍尔唤醒**。
  于是无极性冲突（按键低有效不再进掩码），`eink.ino` 的 `ANY_HIGH` 保持不动；
  GPIO 1/2/9/10 仍取 RTC IO 只是继承布线，无唤醒约束。代价：合盖深睡时按
  按键不会叫醒设备（阅读流是开盖→醒→按键翻页，可接受）。深睡期间按下按键
  仅"醒后首读可能为低"，4 键逻辑读键时忽略开机首个低电平即可。

### 3.5 Hall 霍尔（飞线 3P，DRV5032 模块）

芯序以原理图/本表为准（飞线）：

| 芯 | 网络 | 说明 |
|---|---|---|
| 1 | GND | |
| 2 | 3V3 | **常供电**（深睡电流 µA 级，勿切电） |
| 3 | HALL_OUT | → GPIO4；推挽输出，无上拉 |

- 买**全极性开关型**（锁存型则唤醒逻辑改"任一沿都醒"）。
- ⚠️ 2026-09-29 修正：本表原写 1=3V3/2=GND，与原理图（1=GND/2=3V3）相反；以原理图为准。

### 3.6 Pow 电池输入

| 芯 | 网络 | 连接 | 备注 |
|---|---|---|---|
| 1 | 5V_IN | 电池包 +5V → **R14 0Ω** → +5V 网 → 主控 5V/VIN | 电池包**必须无自动关机/支持常开**（选型硬指标）；R14 为电源入口 0Ω 链接（预留，可切断） |
| 2 | GND | 电池包 − | |

- **电量检测（BAT_SENSE / R10,R11）已从原理图删除**，GPIO8 空出。若要恢复：5V—100kΩ—GPIO8—100kΩ—GND（½ 分压、2.5V），读数在软件里滤波、**不加电容**；100k/100k 常耗 25µA，深睡在意就改 470k/470k。

### 3.7 （仅当 PCB 直接承载主控，而非插 DevKit）

- **EN**：10kΩ↑3V3 + 复位键→GND（可加 1µF 延时）。
- **BOOT**：GPIO0—按键—GND——GPIO0 唯一合法外设。
- **USB**：D−→GPIO19、D+→GPIO20；Type-C 座 CC1/CC2 各 5.1kΩ→GND；**外壳通孔必须焊**（DESIGN §5.11，否则连焊盘撕掉）。
- **3V3 电源**：5V 经 LDO。双屏刷新峰值 300–400mA + 主控余量一起估；**深睡要 µA 级就勿用 AMS1117 当主 LDO**（静态 ~5mA），AMS1117 只作"双屏尖峰重启"的回退方案（DESIGN §2）。

### 3.8 Ams1117 3V3 回退模块（默认 DNP）

3P 端子接成品 AMS1117-3.3 模块（DESIGN §2 的"双屏尖峰顶垮板载 LDO"回退方案）：

| 芯 | 网络 | 说明 |
|---|---|---|
| 3 | +5V（经 R12 0Ω） | 模块输入 |
| 2 | +3V3（经 R13 0Ω） | 模块输出，并入板上 +3V3 网 |
| 1 | GND | |

- ⚠️ **默认 R12/R13 不贴（DNP）**，只在实际实测双屏刷新顶垮开发板 3V3 时才启用。
- ⚠️ AMS1117 输出与开发板 3v3 脚**并联在同一 +3V3 网**：两路同时启用 = 两个 LDO 对顶。启用时须确保只有一路在驱动（或确认开发板 LDO 可被反向偏置而不受损）。
- ⚠️ AMS1117 静态 ~5mA，**常开则深睡 µA 目标报废**（DESIGN §2/§3.7），仅作尖峰回退、不做主 LDO。

## 4. 制板 checklist

- [ ] 每屏 VCI：100µF + 100nF 就近转接板
- [ ] SDCard microSD：VDD 就近 10µF + 100nF；CMD/D0 各 47kΩ 上拉；DAT1/2/3 各 10kΩ 上拉（勿直连 3V3）
- [x] 4 个按键（Btn_*）上拉在主板侧（R6–R9）；信号取上拉脚、另一端接 GND —— 2026-10-08 `key_test/` 实测通过
- [ ] Ams1117：R12/R13 默认 **DNP**（仅双屏尖峰回退时才贴，见 §3.8）；Pow 入口 R14 0Ω
- [ ] 屏 SCK/MOSI 并联走线到 J1/J2；可预留 22Ω 串阻位（先 DNP，长排线振铃再焊）
- [ ] 深睡不断电：屏 VCI、霍尔 3V3 常供
- [ ] §2 禁用脚全部 NC；strapping 脚不拉外部电平
- [ ] 右屏 180° 安装位标注在丝印上
- [ ] （载板时）USB 座外壳通孔焊接

## 5. 代码对应

| 位置 | 内容 |
|---|---|
| `eink.ino:58-70` | 屏 + 霍尔 + 右屏镜像引脚宏 |
| `src/Keys.cpp` (`s_pins`) | 按键 4 脚 GPIO1/2/9/10 + 去抖 20ms/长按 250ms/连发 300ms |
| `src/Keys.h/.cpp` | 4 键事件模型：ISR 边沿队列（刷新 1.3s 内按压不丢）+ poll 判定 |
| `eink.ino:462` `turnPage()` | 对页历史栈（48 深）→ 正向跳页/反向 restorePair 回退 |
| `eink.ino:912` `drainKeys()` | 按键事件消费：并批翻页/选书 + 菜单/字号/家族分发 |
| `src/Storage.cpp:12-16` | SDMMC 38/39/40 + CMD/D0 内部上拉兜底 |
| `DESIGN.md §1.1` | 引脚分配总纲（改脚需三处同步） |
