RobaLinan/dual-ink-reader/assets/books/test_cn.txt

中英混排测试 · Mixed CN/EN Layout Test
=====================================

ESP32-S3 驱动两块 GDEY0583T81 墨水屏（648×480，UC8179 控制器），左屏
CS=14，右屏 CS=18。SD 卡走 SDMMC 1-bit @20MHz，引脚 CLK=38 / CMD=39 /
D0=40 —— 注意 26-32 是 N16R8 内部 Flash 引脚，任何外设都不能用。

这一段验证：汉字按字断行，英文单词不被切断，两者混在一行时像素宽度
要算对（汉字 16px，ASCII 11px）。刷新耗时实测 full 3749ms / fast 1232ms，
双屏重叠只多 66-74ms。Book一翻页应该看不到任何乱码或半截汉字。

标点避头尾测试：下面这些句子故意把句号、逗号、引号顶在可能的换行位置，
正确行为是不允许行首出现。，、；：？！）」》… 等字符；也不允许行尾出现
（「《【[ 等左括号。比如这句的结尾会考察推挤逻辑是否把上一个字和句号一起
挪到下一行，而不是让句号孤零零地站（hang at line start）。正确！

长英文单词和 URL 不能被词中断开：
https://github.com/example/very-long-unbroken-path-segment-for-testing-hard-cut
Email: reader@example.com 传感器型号 DRV5032，全极性开关型。

段落间引用测试：

    "Hello," she said. "这是一段带引号的中文，里面混了 English words
    and（全角括号）以及省略号……还有破折号——和半角省略...交替出现。

    《荷塘月色》节选（朱自清）：曲曲折折的荷塘上面，弥望的是田田的叶子。
    叶子出水很高，像亭亭的舞女的裙。层层的叶子中间，零星地点缀着些白花，
    有袅娜地开着的，有羞涩地打着朵儿的；正如一粒粒的明珠，又如碧天里的
    星星，又如刚出浴的美人。微风过处，送来缕缕清香，仿佛远处高楼上渺茫
    的歌声似的。

中英夹杂的行内混排也常见于技术文档：DMA 通道 0 优先级设为 high，SPI 时钟
分频系数 (divider) 取 2 时是 40MHz，取 4 时是 20MHz。若 PSRAM 分配失败
(ps_malloc returns NULL)，回退栈帧缓冲 malloc，再不行就报 FATAL。

数字与单位：电池 3000mAh，深睡电流几十 µA，阅读整机 100-200mA。温度
范围 -20℃ ~ 70℃，全刷 3s / 快刷 1.5s / 局部 0.3s（数据手册 §7.2）。

全角符号压力行：，。、；：？！（）【】《》〈〉「」『』〔〕｛｝＝＋－×÷±≈≠
半角对照：,. ;:?! () [] {} <> "" '' +-*/= <>和＝要分清。

CJK 扩展与生僻字抽查（缺字会显示方框而不是空白）：〇壹贰叁肆伍陆柒捌玖
喆犇骉麤靐龘朤矐燚。生僻字若不在 Unifont BMP 覆盖内（扩展 B 以上），
预期画 16×16 空心方框，用于区分"缺字"和"真空白"。

The quick brown fox jumps over the lazy dog. pack my box with five dozen
liquor jugs. 0123456789 + - = ( ) [ ] { } / \ | @ # $ % ^ & * _ ~ ` ' "

结尾边界：这一行只有英文 ending here, 换行处应当按单词断开。
最后一行以中文结束，考察行尾不要留下孤立的左括号（
EOF 前的最后几个字是中文结束。下一个字符就是文件结束了，应当自动回卷。
