RobaLinan/dual-ink-reader/PCB/SCH_Schematic1_2026-09-29.pdf

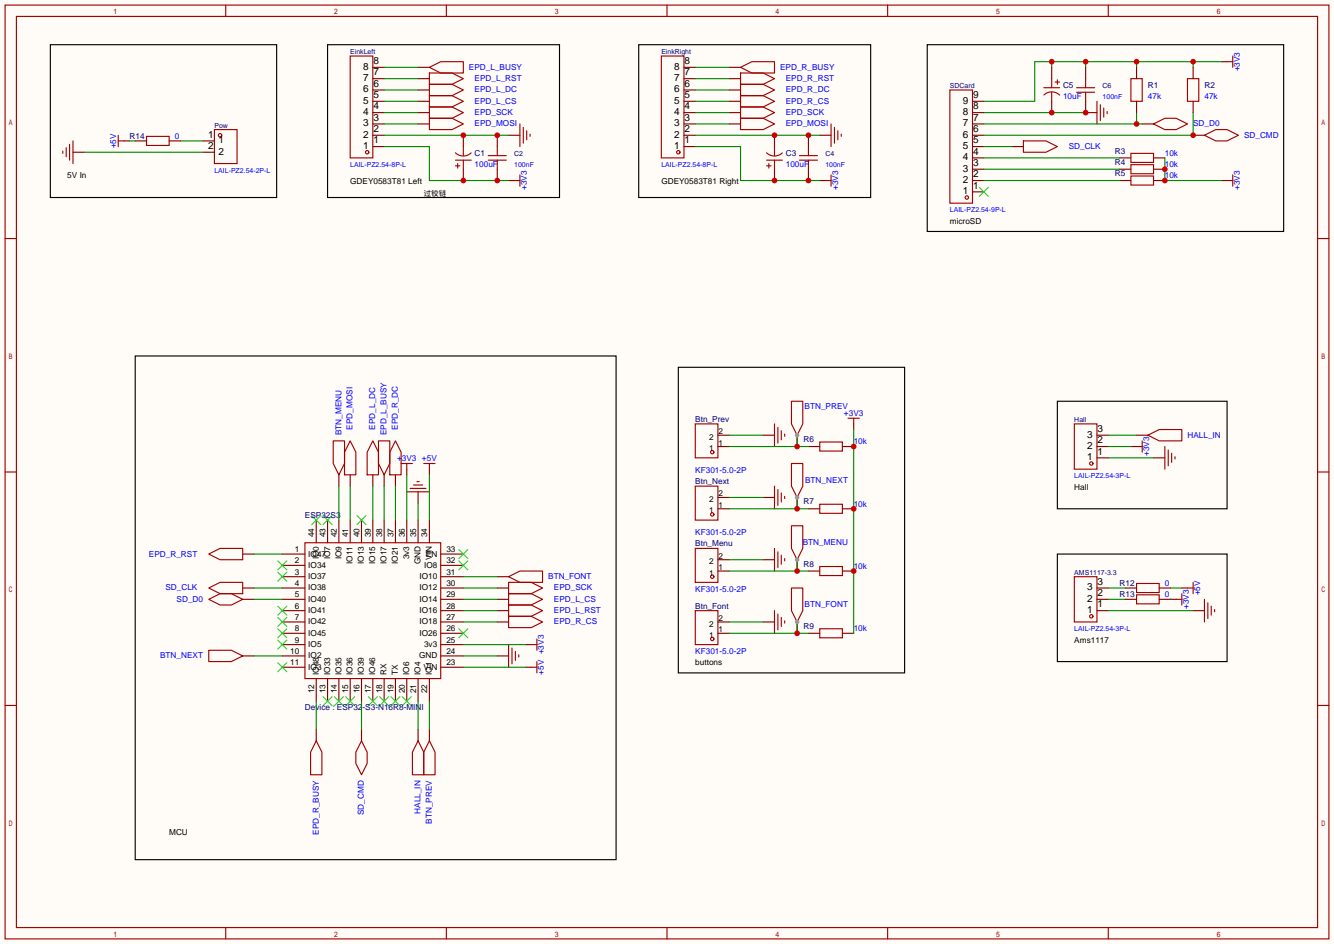
[picture p7: page 1]
