RobaLinan/dual-ink-reader/src/TxtBook.cpp

#include "TxtBook.h"
#include "Storage.h"
#include "CjkFont.h"
#include "EinkPanel.h"
#include "Bookmarks.h"      // hashPath：TXT 目录缓存键与书签键同一哈希
#include "SD_MMC.h"
#include <ESP32epdx.h>
#include <LittleFS.h>
#include <string.h>
#include <stdio.h>
#include <ctype.h>
// 最后 include：Serial 重定向进日志环形缓冲（/debug 网页调试台，DESIGN §11）
#include "DbgLog.h"

// === 排版常量：按像素宽计量（DESIGN §5.5 中英混排）===
// 画布是竖版页 EinkPanel::PAGE_W(480) × PAGE_H(648)（短边为横边），由
// PAGE_ROTATE 旋转进 648×480 显存 —— 这里的行宽/页底全按竖版页逻辑坐标算。
static const int TXT_X       = 8;
static const int TXT_Y0      = 32;   // 页眉(8+16) + 分隔线(26) 之下
static const int HARD_PX     = EinkPanel::PAGE_W - 16;  // 硬上限（档位无关）：8+464=472，
                                    //   末像素 471 < 480 不越界
                                    //   （Paint_SetPixel 边界判断是 > 不是 ≥，
                                    //    逻辑 x=480 会写穿显存行缓冲）
static const int MAXTOK      = 64;   // 单行 token 上限（实算 ≤45，防御）

// 三档字号的运行期参数（TxtBook::setTier 设置）：
//   S(16): Font16 原生 + Unifont16 | 行高18 33行 | 软 464-16=448
//   M(24): Font24 原生 + Unifont1.5× | 行高28 21行 | 软 464-24=440
//   L(32): Font16 2× + Unifont 2×  | 行高36 16行 | 软 464-32=432
//   （行数由 updateGeometry 按 TXT_BOT/TXT_Y0/档宽算，换页高只动 TXT_BOT）
//   软预算 = HARD_PX - s_cjkPx：给避头悬挂留出最大字宽，悬挂后仍 ≤464。
//   家族包模式（CJK.packActive()）下行几何另算：行距按包的基线/行盒度量，
//   软预算按包 maxAdv；步进逐字取真实 advance（proportional）。
static int s_asciiPx = 11, s_cjkPx = 16;
static int s_linePx  = 448;          // 软预算
static int s_lineH   = 18;           // 行高
static int s_maxline = 33;           // 每页行数
static int s_asciiMode = 1;          // 0=Font24 原生 / 1=Font16 原生 / 2=Font16 2× 放大
static const int TXT_BOT = EinkPanel::PAGE_H - 18;   // 正文墨迹底界（页底留 18px 余量）

// 行缓冲 = UTF-8 字节流；token 表记每段的起点/前缀像素宽/文件位置（页尾回退用）
static char s_line[256];
static int s_lineLen = 0, s_px = 0, s_lines = 0;
static bool s_pendingSpace = false;
static long s_lineStart = 0, s_pageStart = 0;
static long s_rewindPos = -1;   // 页尾回退位：图整页放不下时 = 图标记的文件位置
                                // （-1 = 无。与 s_lineStart 回退互补，见 renderPage 尾部）
static bool s_hadContent = false; // 本页是否落过实际内容（文本行/图块）。
                                // EPUB（m_loop=false）纯空白页（只有空行/直接 EOF）
                                // 据此返回 false → 调用方跳过该页推进，不渲
                                // "有页码的空白页"（漫画章尾 "\n\n"，DESIGN §12）
static TxtBook::BookImgMeasureFn s_imgMeas = nullptr;   // EPUB 插图回调（EpubBook 注册）
static TxtBook::BookImgDrawFn s_imgDraw = nullptr;
static void* s_imgCtx = nullptr;

void TxtBook::setImageFns(BookImgMeasureFn m, BookImgDrawFn d, void* ctx) {
  s_imgMeas = m; s_imgDraw = d; s_imgCtx = ctx;
}

struct Tok { uint16_t off; uint16_t prePx; uint32_t wStart; };
static Tok s_tok[MAXTOK];
static int s_ntok = 0;

// ---- UTF-8 解码 ----
// 从字节流解一个码点：*used = 消耗字节数；非法序列 → '?' 且消耗 1
static uint32_t utf8At(const char* s, int len, int* used) {
  const uint8_t* p = (const uint8_t*)s;
  if (len <= 0) { *used = 0; return '?'; }
  uint8_t b = p[0];
  if (b < 0x80) { *used = 1; return b; }
  int extra; uint32_t cp;
  if ((b & 0xE0) == 0xC0)      { cp = b & 0x1F; extra = 1; }
  else if ((b & 0xF0) == 0xE0) { cp = b & 0x0F; extra = 2; }
  else if ((b & 0xF8) == 0xF0) { cp = b & 0x07; extra = 3; }
  else                         { *used = 1; return '?'; }
  if (extra >= len) { *used = 1; return '?'; }
  for (int i = 1; i <= extra; i++) {
    if ((p[i] & 0xC0) != 0x80) { *used = i; return '?'; }
    cp = (cp << 6) | (p[i] & 0x3F);
  }
  *used = extra + 1;
  return cp;
}

// 读一个"源码点"：UTF-8 解码 + 常见西文标点归一到 ASCII（英文排版走 Font16 不变）。
// raw[]/rawLen 带出原始字节（宽字符 token 要原样入行缓冲）。返回 -1 = EOF
static int txtGetCp(File& f, char raw[4], int* rawLen) {
  uint8_t b;
  if (f.read(&b, 1) != 1) return -1;
  raw[0] = (char)b;
  *rawLen = 1;
  if (b < 0x80) {
    if (b == 0x7F) return '?';
    return b;
  }
  int extra; uint32_t cp;
  if ((b & 0xE0) == 0xC0)      { cp = b & 0x1F; extra = 1; }
  else if ((b & 0xF0) == 0xE0) { cp = b & 0x0F; extra = 2; }
  else if ((b & 0xF8) == 0xF0) { cp = b & 0x07; extra = 3; }
  else                         { return '?'; }
  for (int i = 1; i <= extra; i++) {
    uint8_t c2;
    if (f.read(&c2, 1) != 1) return -1;
    raw[i] = (char)c2;
    *rawLen = i + 1;
    if ((c2 & 0xC0) != 0x80) return '?';
    cp = (cp << 6) | (c2 & 0x3F);
  }
  switch (cp) {
    case 0x2018: case 0x2019: return '\'';
    case 0x201C: case 0x201D: return '"';
    case 0x2013: case 0x2014: case 0x2212: return '-';
    case 0x00A0: return ' ';
    default: return (int)cp;
  }
}

// ---- 分类 ----
static bool isWide(uint32_t cp) {
  return (cp >= 0x2E80 && cp <= 0x303E) ||   // 部首/符号/注音/假名起
         (cp >= 0x3041 && cp <= 0x33FF) ||   // 假名、兼容
         (cp >= 0x3400 && cp <= 0x4DBF) ||   // 扩展 A
         (cp >= 0x4E00 && cp <= 0x9FFF) ||   // 统一汉字
         (cp >= 0xAC00 && cp <= 0xD7A3) ||   // 谚文
         (cp >= 0xF900 && cp <= 0xFAFF) ||   // 兼容汉字
         (cp >= 0xFE30 && cp <= 0xFE6F) ||
         (cp >= 0xFF00 && cp <= 0xFF60) ||   // 全角形式
         (cp >= 0xFFE0 && cp <= 0xFFE6);
}

// 避头尾（DESIGN §5.5）：行首禁则 = 收尾类标点，行尾禁则 = 起始类括号
static bool isBadStart(uint32_t cp) {
  switch (cp) {
    case 0x3001: case 0x3002: case 0xFF0C: case 0xFF01: case 0xFF1F:
    case 0xFF1B: case 0xFF1A: case 0xFF09: case 0xFF0D: case 0x3011:
    case 0x3009: case 0x300B: case 0x300D: case 0x300F: case 0x2026:
    case ',': case '.': case ';': case ':': case '!': case '?':
    case ')': case ']': case '}': case '%': case '\'': case '"':
      return true;
    default: return false;
  }
}
static bool isBadEnd(uint32_t cp) {
  switch (cp) {
    case 0x3008: case 0x300A: case 0x300C: case 0x300E: case 0x3010:
    case 0x3014: case 0xFF08: case '(': case '[': case '{':
      return true;
    default: return false;
  }
}

// 当前字体状态下 cp 的排版步进：家族包 = 真实 advance（proportional，
// 含弯引号/重音等全部码点）；包缺字回退档位估值；classic = 档位固定值。
static int advPx(uint32_t cp) {
  if (CJK.packActive()) {
    int a = CJK.packAdv(cp);
    if (a >= 0) return a;
    return isWide(cp) ? s_cjkPx : s_asciiPx;
  }
  return cp < 0x80 ? s_asciiPx : s_cjkPx;
}
static int pxOf(const char* b, int len) {
  int px = 0, i = 0;
  while (i < len) { int u; px += advPx(utf8At(b + i, len - i, &u)); i += u; }
  return px;
}

// Font16 点阵按 2× 最近邻放大（L 档英文：字高 32、步进 22，与 Font16 数据布局一致：
//   11 列/行 → 每行 ceil(11/8)=2 字节，MSB=最左）
static void drawAscii16x2(int x, int y, char c) {
  if (c < ' ' || c > '~') c = '?';
  const int CW = 11, CH = 16, RB = 2;
  const uint8_t* p = Font16.table + (c - ' ') * RB * CH;
  for (int r = 0; r < CH; r++)
    for (int col = 0; col < CW; col++)
      if (p[r * RB + col / 8] & (0x80 >> (col % 8)))
        for (int dy = 0; dy < 2; dy++)
          for (int dx = 0; dx < 2; dx++)
            Paint_SetPixel(x + col * 2 + dx, y + r * 2 + dy, BLACK);
}

// ---- 行上落 token ----
// 画出当前行并开新行。false = 页满不画不重置（调用方回退文件，内容不丢）
static bool flushLine() {
  if (s_lines >= s_maxline) return false;
  if (s_lineLen > 0) s_hadContent = true;   // 空行（无字符）不算内容
  s_line[s_lineLen] = '\0';
  int y = TXT_Y0 + s_lines * s_lineH;
  int x = TXT_X, i = 0;
  while (i < s_lineLen) {               // 混排绘制
    int u;
    uint32_t cp = utf8At(s_line + i, s_lineLen - i, &u);
    if (CJK.packActive()) {             // 家族包：全部走包字形（对齐基线），真实步进
      CJK.drawGlyph(x, y, cp, s_cjkPx); // 缺字回退 Unifont 放大 / 方框
      x += advPx(cp);
    } else if (cp < 0x80) {
      if (s_asciiMode == 2)      drawAscii16x2(x, y, (char)cp);
      else if (s_asciiMode == 0) Paint_DrawChar(x, y, (char)cp, &Font24, BLACK, WHITE);
      else                       Paint_DrawChar(x, y, (char)cp, &Font16, BLACK, WHITE);
      x += s_asciiPx;
    } else {
      CJK.drawGlyph(x, y, cp, s_cjkPx);
      x += s_cjkPx;
    }
    i += u;
  }
  s_lines++;
  s_lineLen = 0; s_px = 0; s_ntok = 0;
  return true;
}

// 追加一个 token（含前导空格）。false = 页满且刷不下去（行里已有内容 → 回退安全）
static bool appendTok(const char* b, int len, int px, uint32_t wStart) {
  if (s_ntok >= MAXTOK && !flushLine()) return false;
  if (s_lineLen + len + 2 > (int)sizeof(s_line) && !flushLine()) return false;
  Tok t;
  t.off = s_lineLen;
  t.prePx = s_px;
  t.wStart = wStart;
  if (s_ntok == 0) s_lineStart = wStart;
  bool sep = s_pendingSpace && s_px > 0;
  if (sep) { s_line[s_lineLen++] = ' '; s_px += advPx(' '); t.off = s_lineLen - 1; }
  memcpy(s_line + s_lineLen, b, len);
  s_lineLen += len;
  s_px += px;
  s_tok[s_ntok++] = t;
  s_pendingSpace = false;
  return true;
}

// 前缀字节宽不超过 budgetPx 的切割点（超长词硬切用），至少切 1 个码点
static int cutPoint(const char* b, int len, int budgetPx) {
  int i = 0, px = 0;
  while (i < len) {
    int u;
    uint32_t cp = utf8At(b + i, len - i, &u);
    if (px + advPx(cp) > budgetPx && i > 0) break;
    px += advPx(cp);
    i += u;
  }
  return i;
}

static char s_carry[200];   // 推挤暂存：承载 token ≤ 单词缓冲 192B（见 placeToken）

// 把一个 token 放进当前行。放不下：避头悬挂 → 推挤（上一 token 挪下去同行）→
// 换行 → 超长词硬切。返回 false = 本页已满未放入（调用方停止读、页尾回退）
static bool placeToken(const char* b, int len, int px, uint32_t wStart) {
  for (int guard = 0; guard < 12; guard++) {
    bool sep = s_pendingSpace && s_px > 0;
    int need = (sep ? advPx(' ') : 0) + px;
    if (s_px + need <= s_linePx) return appendTok(b, len, px, wStart);

    if (s_ntok == 0) {                       // 空行放不下 = 超长词硬切
      int cut = cutPoint(b, len, s_linePx);
      int cpx = pxOf(b, cut);
      if (!appendTok(b, cut, cpx, wStart)) return false;
      if (s_lines >= s_maxline) return false;      // 回退到本行首（前缀已在缓冲）
      flushLine();
      b += cut; len -= cut; px -= cpx; wStart += cut;
      s_pendingSpace = false;
      continue;
    }

    int u;
    uint32_t firstCp = utf8At(b, len, &u);
    Tok last = s_tok[s_ntok - 1];
    uint32_t lastCp = '?';
    { int i = last.off, lu;                       // 行内最后一个 token 的末码点
      while (i < s_lineLen) { lastCp = utf8At(s_line + i, s_lineLen - i, &lu); i += lu; } }

    // 避头：行首禁则字符挂到行尾（吞右边距，最多 16px，不越屏）
    if (isBadStart(firstCp) && s_px + px <= HARD_PX)
      return appendTok(b, len, px, wStart);

    // 需要换行。避头（前面还有东西可挪）或避尾（上一是开括号）→ 推挤同行
    if (s_ntok >= 2 && (isBadStart(firstCp) || isBadEnd(lastCp)) &&
        s_lines < s_maxline) {                 // 页满就别动行（回退即安全）
      int carryOff = last.off;
      int carryLen = s_lineLen - carryOff;
      int carryPx = s_px - last.prePx;
      bool keepPending = s_pendingSpace;         // 属于原 token 的前导空格，别丢
      if (carryLen > 0 && carryLen <= (int)sizeof(s_carry)) {
        if (s_line[carryOff] == ' ') {           // 行首不留空格：剥掉 carry 的前导空格
          carryOff++; carryLen--; carryPx -= advPx(' ');
        }
        memcpy(s_carry, s_line + carryOff, carryLen);
        s_ntok--;                                // 摘下 carry
        s_lineLen = last.off;
        s_px = last.prePx;
        flushLine();                             // 页满已预检，必成功
        if (!appendTok(s_carry, carryLen, carryPx, last.wStart)) return false;
        s_pendingSpace = keepPending;
        continue;                                // 再试放原 token（新行几乎必放得下）
      }
    }
    // 普通换行
    if (!flushLine()) return false;
    s_pendingSpace = false;
  }
  return false;   // 不变量兜底（到不了）
}

// 词（ASCII/窄字符连续段）入行。false = 页满未放入（调用方须停止读取）
static bool placeWord(const char* w, int len, uint32_t wStart) {
  return len == 0 || placeToken(w, len, pxOf(w, len), wStart);
}

// ---- EPUB 插图标记（转换期 EpubBook::collectText 把 <img> 写成独占一行的
// ASCII 标记 [[img:<zip 内路径>]]：路径空格 %20 转义保证不被分词拆开，总长
// ≤160B 行/词缓冲 192B 装得下；纯 TXT 正文不会出现 "[[" 前缀形态） ----
static bool isImgMarker(const char* w, int len) {
  return len > 8 && memcmp(w, "[[img:", 6) == 0 && w[len - 2] == ']' && w[len - 1] == ']';
}

// 图块落页：先画掉行内已有文本（图独占一行），量高度（不解码），
// 放得下就绘制并按行高占位；放不下分两态——页首硬压进一页（防死循环），
// 页中推给下一页顶部（s_rewindPos 回退）。
// false = 本页到此为止（行文本未画走常规回退 / 图回退位已记录）
static bool placeImageBlock(const char* path, int len, uint32_t wStart) {
  char p[160];
  if (len >= (int)sizeof(p)) len = (int)sizeof(p) - 1;
  memcpy(p, path, len); p[len] = '\0';

  if (s_lineLen > 0 && !flushLine()) return false;   // 页满：行未画，s_lineStart 回退
  if (!s_imgMeas) return true;                       // 无解码器：跳过（防御）

  int y = TXT_Y0 + s_lines * s_lineH;
  int maxH = TXT_BOT - y;                            // 剩余垂直空间（循环条件保证 >0）
  int h = 0;
  if (!s_imgMeas(s_imgCtx, p, HARD_PX, &h) || h <= 0) return true;  // 坏图：跳过不阻塞
  int need = (h + s_lineH - 1) / s_lineH;
  int room = s_maxline - s_lines;
  if (need > room) {
    if (s_lines > 0) { s_rewindPos = (long)wStart; return false; }  // 推下一页整图画
    need = room;                                     // 页首：再高的图也压进本页
  }
  int drawH = need * s_lineH;
  if (drawH > maxH) drawH = maxH;                    // 几何兜底（截断后应不触发）
  s_hadContent = true;                               // 图块占位即内容（坏图在上面已 return）
  if (s_imgDraw) s_imgDraw(s_imgCtx, p, TXT_X, y, HARD_PX, drawH);
  s_lines += need;
  return true;
}

// 词收尾统一入口：认插图标记，其余照旧按词入版
static bool placeContent(const char* w, int len, uint32_t wStart) {
  if (isImgMarker(w, len)) return placeImageBlock(w + 6, len - 8, wStart);
  return placeWord(w, len, wStart);
}

// ---- TxtBook ----
// 行几何随字号档 + 家族联动：classic 用档位表；家族包用包内基线/行盒/maxAdv 度量。
// 每页行数统一按墨迹盒算（换页高只动 TXT_BOT）：
//   n = (TXT_BOT - TXT_Y0 - 盒高) / 行高 + 1   —— 横版 462 时正好还原 24/15/12
static void updateGeometry() {
  int box;   // 行内墨迹盒高：classic = 档位字高；家族包 = 基线 + 最大下伸
  if (CJK.packActive()) {
    box = CJK.baselineY() + CJK.maxDescent();
    s_lineH = box + s_cjkPx / 8;                    // 行距 16→+2 / 24→+3 / 32→+4
  } else {
    box = s_cjkPx;
    switch (s_cjkPx) {
      case 24: s_lineH = 28; break;
      case 32: s_lineH = 36; break;
      default: s_lineH = 18; break;
    }
  }
  int n = (TXT_BOT - TXT_Y0 - box) / s_lineH + 1;
  s_maxline = n > 0 ? n : 1;
  // 软预算与 classic 同规则：悬挂路径另有 <=HARD_PX 显式检查兜底，
  // 不必按包 maxAdv 收缩（U+2E3B 三倍宽破折号那种 78px 特例会白扔行宽）
  s_linePx = HARD_PX - s_cjkPx;
}

void TxtBook::setTier(uint8_t sizePx) {
  switch (sizePx) {
    case 24: s_asciiPx = 17; s_cjkPx = 24; s_asciiMode = 0; break;
    case 32: s_asciiPx = 22; s_cjkPx = 32; s_asciiMode = 2; break;
    default: s_asciiPx = 11; s_cjkPx = 16; s_asciiMode = 1; break;
  }
  if (CJK.packActive())              // 家族包按新档位重载（缺该档文件 → 自动回 classic）
    CJK.setFamily(CJK.currentFamily(), s_cjkPx);
  updateGeometry();
}

bool TxtBook::setFamily(const char* name) {
  int idx = name ? CJK.familyIndex(name) : 0;
  if (idx < 0) idx = 0;
  bool ok = CJK.setFamily(idx, s_cjkPx);
  updateGeometry();
  return ok;
}

// 关句柄：切书与 SD 重挂载前调用。只动 m_file/m_ok —— m_page/m_pairStart
// 保留，切走前 saveProgress() 还要读它们（进度不丢）
void TxtBook::close() {
  if (m_file) m_file.close();
  m_ok = false;
}

bool TxtBook::open(const char* path) { return open(SD_MMC, path); }

bool TxtBook::open(fs::FS& fs, const char* path) {
  if (m_ok) close();          // 允许重开（EpubBook 每章换临时文本文件）
  // 流式状态每次 open 归零（原逻辑只在"开着时重开"分支里重置 → 先 close 再
  // open 会把上一章的 m_hitEof/m_pairStart 带进新章，EPUB 右页会误判章末）；
  // m_page/m_pairStart 的恢复由调用方显式 restorePair 做，open 不该继承
  m_hitEof = false;
  m_page = 0;
  m_pairStart = -1;
  m_avgNum = 0; m_avgDen = 0;   // 平均页字节重新累计（跳转页号估算用）
  m_permille = -1;              // 进度显示回到"自行按字节算"
  m_nToc = -1;                  // 目录缓存失效（书可能换了），下次 tocCount 重扫
  m_fs = &fs;
  snprintf(m_path, sizeof(m_path), "%s", path);
  if (!Storage::begin()) return false;

  setTier(TXT_SIZE_PX);            // 默认档（TxtBook.h 可改），按键阶段可运行期切换

  // 挂载刚过就开文件偶发失败（卡初始化完还在忙，2026-09-24 实测：挂载重试
  // 成功后首开 /books/test_cn.txt 失败、下一个候选却秒开）。100ms 退避重试
  for (int i = 0; i < 3 && !m_file; i++) {
    if (i) delay(100);
    m_file = fs.open(path, FILE_READ);
  }
  if (!m_file) {
    Serial.printf("WARN: cannot open %s\n", path);
    return false;
  }
  m_ok = true;
  if (!m_quiet)   // EPUB 章节临时文件（setQuiet 在 open 前置位）不刷这行
    Serial.printf("[SD] %s: %lu bytes\n", path, (unsigned long)m_file.size());

  const char* base = path[0] == '/' ? path + 1 : path;
  if (!m_titleOverridden)
    snprintf(m_title, sizeof(m_title), "%s", base);

  if (!m_quiet) {
    char dump[401];
    int n = m_file.read((uint8_t*)dump, 400);
    if (n > 0) {
      dump[n] = '\0';
      Serial.println("--- head 400B ---");
      Serial.println(dump);
      Serial.println("--- head end ---");
    }
    m_file.seek(0);
  }

  CJK.begin("/fonts/unifont.bin");   // 缺了只警告，CJK 画方框，英文不受影响
  return true;
}

bool TxtBook::renderPair(uint8_t* fbL, uint8_t* fbR) {
  if (!m_ok) return false;
  m_pairStart = m_file.position();          // 记录本对页起点（字体切换时回跳重排）
  m_pairStartPage = m_page;
  // 页眉进度%按对页起点算（直接算，不调 permille()——它优先返回注入值会自锁；
  // EPUB 的 m_txt 不走这里，由 EpubBook::renderPair 注入全局值）
  { uint32_t sz = m_file.size();
    m_permille = (sz && m_pairStart >= 0)
                     ? (int)((uint64_t)m_pairStart * 1000 / sz) : -1; }
  bool ok = renderPage(fbL, m_page) && renderPage(fbR, m_page + 1);
  if (!ok) { m_ok = false; return false; }
  m_page += 2;
  return true;
}

// 回到最近一次 renderPair 的起点（切换字体/字号后调用，再 renderPair 即同页重排）
bool TxtBook::restartPair() {
  if (!m_ok || m_pairStart < 0) return false;
  if (!m_file.seek(m_pairStart)) return false;
  m_page = m_pairStartPage;
  return true;
}

// 深睡唤醒恢复：seek 回存档的对页起点并登记为"当前对页"（不渲染）
bool TxtBook::restorePair(long off, uint32_t page) {
  if (!m_ok || off < 0) return false;
  if (!m_file.seek(off)) return false;
  m_page = page;
  m_pairStart = off;
  m_pairStartPage = page;
  return true;
}

// 覆盖页眉标题（EPUB 用书名+章节号，不用临时文件名）
void TxtBook::setTitle(const char* t) {
  if (t) {
    snprintf(m_title, sizeof(m_title), "%s", t);
    m_titleOverridden = true;
  } else {
    m_title[0] = '\0';
    m_titleOverridden = false;
  }
}

// 页眉混排（文件名可能带中文），固定 Font16 / 16px 不随档位。
// 竖版页只有 480px 宽（长文件名+页码放不下）：放不下就截断 —— 逻辑 x=480 会
// 写穿显存（Paint_SetPixel 边界是 > 不是 ≥，旋转后 x 映射成显存行号）
static void drawHeader(const char* hdr) {
  int i = 0, x = TXT_X;
  while (hdr[i]) {
    int u;
    uint32_t cp = utf8At(hdr + i, (int)strlen(hdr) - i, &u);
    int adv = cp < 0x80 ? 11 : 16;
    if (x + adv > EinkPanel::PAGE_W) break;   // 末像素 ≤479 才画
    if (cp < 0x80) Paint_DrawChar(x, 8, (char)cp, &Font16, BLACK, WHITE);
    else CJK.drawGlyph(x, 8, cp, 16);
    x += adv;
    i += u;
  }
}

// 页眉文本：有进度（自行按字节算或 EPUB 注入）时 "title   p.N · 42%"，
// 未知时退回旧格式 "title   page N"。% 取整四舍五入。
static void makeHeader(char* hdr, size_t n, const char* title, uint32_t pageNo, int permille) {
  if (permille >= 0 && permille <= 1000)
    snprintf(hdr, n, "%s   p.%lu %u%%", title, (unsigned long)pageNo,
             (unsigned)(permille + 5) / 10);
  else
    snprintf(hdr, n, "%s   page %lu", title, (unsigned long)pageNo);
}

// 空白页（页眉+分隔线，正文全白）：EPUB 章节在右页中间结束
void TxtBook::renderBlank(uint8_t* fb, uint32_t pageNo) {
  Paint_SelectImage(fb);
  Paint_Clear(WHITE);
  char hdr[64];
  makeHeader(hdr, sizeof(hdr), m_title, pageNo, m_permille);
  drawHeader(hdr);
  Paint_DrawLine(TXT_X, 26, EinkPanel::PAGE_W - 1 - TXT_X, 26,
                 BLACK, LINE_STYLE_SOLID, DOT_PIXEL_1X1);
}

// 渲染一页（页眉+分隔线+正文）。文件位置持续推进 → 左右屏天然连续；
// 页尾半行回退不丢字（s_lineStart = 当前行首 token 的文件位置）。
// m_loop=false（EPUB）：EOF 后不再回卷，m_hitEof 置位返回
bool TxtBook::renderPage(uint8_t* fb, uint32_t pageNo) {
  if (!m_file) return false;
  Paint_SelectImage(fb);
  Paint_Clear(WHITE);

  char hdr[64];
  makeHeader(hdr, sizeof(hdr), m_title, pageNo, m_permille);
  drawHeader(hdr);                              // 页眉也走混排（文件名可能带中文）
  Paint_DrawLine(TXT_X, 26, EinkPanel::PAGE_W - 1 - TXT_X, 26,
                 BLACK, LINE_STYLE_SOLID, DOT_PIXEL_1X1);

  m_hitEof = false;
  s_lineLen = 0; s_px = 0; s_lines = 0; s_ntok = 0;
  s_pendingSpace = false;
  s_hadContent = false;
  s_rewindPos = -1;
  s_pageStart = m_file.position();
  s_lineStart = s_pageStart;

  char word[192];
  int wlen = 0;
  uint32_t wStart = s_pageStart;
  bool eof = false, rewound = false;
  uint32_t t0 = millis();
  long before;

  while (s_lines < s_maxline) {
    char raw[4]; int rawLen = 0;
    before = m_file.position();
    int cp = eof ? -1 : txtGetCp(m_file, raw, &rawLen);
    if (cp < 0) {
      eof = true;
      m_hitEof = true;                       // EPUB 章末信号（loop 模式下同置位，无害）
      if (s_lines == 0 && s_lineLen == 0 && wlen == 0) {
        if (!m_loop || rewound) break;       // 非循环：没有更多内容；空文件兜底
        rewound = true;
        m_file.seek(0);                      // EOF 回卷：TXT 翻过末页后从头再来
        eof = false;
        m_hitEof = false;
        continue;
      }
    } else if (cp == '\n') {
      // 任一步骤因页满失败 → 立即停读；缓冲里有未画内容，页尾回退不丢字
      if (!placeContent(word, wlen, wStart)) break;
      wlen = 0;
      if (!flushLine()) break;
      s_lineStart = m_file.position();
      s_pendingSpace = false;
    } else if (cp == ' ' || cp == '\t' || cp == '\r' || cp < 0x20 || cp == 0x3000) {
      if (!placeContent(word, wlen, wStart)) break;
      wlen = 0;
      s_pendingSpace = true;
    } else if (isWide(cp)) {
      // 宽字符（汉字/全角标点）：独立 token，两端都是断点
      if (!placeContent(word, wlen, wStart)) break;
      wlen = 0;
      if (!placeToken(raw, rawLen, s_cjkPx, (uint32_t)before)) break;
    } else {
      // ASCII/窄字符并入当前词（词内不断）
      if (wlen == 0) wStart = before;
      if (wlen + rawLen < (int)sizeof(word)) {
        memcpy(word + wlen, raw, rawLen);
        wlen += rawLen;
      } else {
        if (!placeContent(word, wlen, wStart)) break;   // 超长 token 防溢出
        wlen = 0;
        if (!placeToken(raw, rawLen, advPx(cp), (uint32_t)before)) break;
      }
    }
    if (eof) {
      if (wlen) { placeContent(word, wlen, wStart); wlen = 0; }
      if (s_lineLen > 0 && s_lines < s_maxline) flushLine();
      break;
    }
  }
  // 页尾回退，两种互补：
  //   s_rewindPos ≥ 0 = 图整页放不下（记录的是图标记位置）→ 留给下页顶部
  //   s_lineLen > 0   = 末行没画完 → 回退到行首，下页从这里重读（不丢不重）
  if (s_rewindPos >= 0) m_file.seek(s_rewindPos);
  else if (s_lineLen > 0) m_file.seek(s_lineStart);

  // 平均页字节累计（跳转页号估算用）：EOF 回卷会让 position 小于页起点，只记正值
  { long d = (long)m_file.position() - s_pageStart;
    if (d > 0) { m_avgNum += (uint32_t)d; m_avgDen++; } }

  Serial.printf("[txt] page %lu: pos %ld->%ld, %d lines, %lu ms\n",
                (unsigned long)pageNo, s_pageStart, (long)m_file.position(),
                s_lines, (unsigned long)(millis() - t0));
  // 返回值分两种语义：
  //   TXT（m_loop=true）：照旧 s_lines>0（纯空行页也算一页，行为不变）；
  //   EPUB（m_loop=false）：无内容（s_hadContent=false）→ false。纯空白页
  //   （章尾残留 "\n\n"、空章）交给 EpubBook::renderPair 的跳过/推进逻辑，
  //   不再占用一个面板画"有页码的空白页"（漫画对页配对的前提，DESIGN §12）
  return m_loop ? (s_lines > 0) : s_hadContent;
}

// ==== 阅读功能（2026-10-12：进度%/目录/跳转）================================

// 全书进度千分比：字节偏移/文件大小（EPUB 由 EpubBook 注入全局值，不走这里）
uint16_t TxtBook::permille() {
  if (m_permille >= 0 && m_permille <= 1000) return (uint16_t)m_permille;
  if (!m_file) return 0xFFFF;
  uint32_t sz = m_file.size();
  if (!sz) return 0xFFFF;
  long pos = m_pairStart >= 0 ? m_pairStart : (long)m_file.position();
  if (pos < 0) pos = 0;
  uint32_t p = (uint32_t)((uint64_t)pos * 1000 / sz);
  return p > 1000 ? 1000 : (uint16_t)p;
}

long TxtBook::offAtPermille(uint16_t p) const {
  if (!m_file) return -1;
  uint32_t sz = m_file.size();
  return (long)((uint64_t)p * sz / 1000);
}

uint32_t TxtBook::estPageAt(long off) const {
  if (!m_avgNum || !m_avgDen) return 0;
  uint32_t pg = (uint32_t)((uint64_t)off * m_avgDen / m_avgNum);
  return pg & ~1u;          // 对页对齐（页号永远偶数起点，与 renderPair 语义一致）
}

// 跳转定位（进度%/目录/书签共用）：seek 后向前对准 UTF-8 字符边界
// （按字节算的 % 可能落进多字节序列中间），页号按平均页字节估算。
// 不渲染；调用方随后 runRefresh 重画。
bool TxtBook::seekTo(long off) {
  if (!m_ok || !m_file) return false;
  long sz = (long)m_file.size();
  if (sz <= 0) return false;
  if (off < 0) off = 0;
  if (off >= sz) off = sz - 1;
  if (!m_file.seek(off)) return false;
  while (off < sz - 1) {                 // 跳过接续字节 (10xxxxxx)
    uint8_t b;
    if (m_file.read(&b, 1) != 1) break;
    if ((b & 0xC0) != 0x80) break;
    off++;
  }
  if (!m_file.seek(off)) return false;
  m_page = estPageAt(off);
  m_pairStart = -1;                      // 下一 renderPair 重记对页起点
  return true;
}

int TxtBook::tocCount() {
  if (m_nToc < 0) scanToc();
  return m_nToc;
}

bool TxtBook::jumpToToc(int idx) {
  if (idx < 0 || idx >= tocCount()) return false;
  return seekTo(m_tocOff[idx]);          // 章节标题行首 = 天然页起点
}

// 目录标题回读：独立文件句柄（不碰排版游标），取标题行并去尾空白
bool TxtBook::tocTitle(int idx, char* out, int n) {
  if (out && n > 0) out[0] = '\0';
  if (!out || n <= 0 || idx < 0 || idx >= tocCount() || !m_fs || !m_path[0])
    return false;
  File f = m_fs->open(m_path, FILE_READ);
  if (!f) return false;
  f.seek(m_tocOff[idx]);
  int got = f.read((uint8_t*)out, n - 1);
  f.close();
  if (got < 0) got = 0;
  out[got] = '\0';
  char* nl = strchr(out, '\n');          // 截到行尾
  if (nl) *nl = '\0';
  while (got > 0 && (out[got - 1] == '\r' || out[got - 1] == ' ' || out[got - 1] == '\t'))
    out[--got] = '\0';
  return true;
}

// 行内容是否为章节标题（启发式，短行 + 行首模式）：
//   "第X章/回/节/卷/部/篇"（X = 数字或中文数字）、"Chapter N"、整行短词
//   （序章/前言/楔子/尾声/后记…）。误报无害（多一个目录项），漏报不修。
static bool isChapterHeading(const char* s, int len) {
  if (len <= 0 || len > 78) return false;
  int i = 0;
  while (i < len && (s[i] == ' ' || s[i] == '\t') && i < 4) i++;
  if (len - i >= 3 && (uint8_t)s[i] == 0xE3 && (uint8_t)s[i + 1] == 0x80 &&
      (uint8_t)s[i + 2] == 0x80)                       // 全角空格 U+3000
    i += 3;
  const char* p = s + i;
  int n = len - i;
  if (n <= 0) return false;

  if (n >= 8 && strncasecmp(p, "chapter", 7) == 0 &&
      (p[7] == ' ' || p[7] == '\t' || isdigit((uint8_t)p[7])))
    return true;

  static const char* whole[] = {   // 整行短词
    "\xE5\xBA\x8F\xE7\xAB\xA0",   // 序章
    "\xE5\xBA\x8F\xE8\xA8\x80",   // 序言
    "\xE5\x89\x8D\xE8\xA8\x80",   // 前言
    "\xE5\xBC\x95\xE8\xA8\x80",   // 引言
    "\xE6\xA5\x94\xE5\xAD\x90",   // 楔子
    "\xE5\xBA\x8F\xE5\xB9\x95",   // 序幕
    "\xE5\xB0\xBE\xE5\xA3\xB0",   // 尾声
    "\xE5\x90\x8E\xE8\xAE\xB0",   // 后记
    "\xE7\x95\xAA\xE5\xA4\x96",   // 番外
    "\xE7\xBB\x88\xE7\xAB\xA0",   // 终章
    NULL };
  for (int w = 0; whole[w]; w++)
    if (n == (int)strlen(whole[w]) && memcmp(p, whole[w], n) == 0) return true;

  // 第<num>章/回/节/卷/部/篇：首个码点 = 第，其后 ≤16 个码点内出现章回节卷部篇，
  // 中间只允许数字/中文数字（一二三四五六七八九十百千万零两〇）
  int u;
  uint32_t cp = utf8At(p, n, &u);
  if (cp != 0x7B2C) return false;                      // 第
  i = u;
  int cps = 0;
  while (i < n && cps < 16) {
    cp = utf8At(p + i, n - i, &u);
    i += u; cps++;
    if (cp == 0x7AE0 || cp == 0x8282 || cp == 0x56DE || cp == 0x5377 ||
        cp == 0x90E8 || cp == 0x7BC7)                  // 章节回卷部篇
      return true;
    bool numeral = (cp >= '0' && cp <= '9') ||
        cp == 0x4E00 || cp == 0x4E8C || cp == 0x4E09 || cp == 0x56DB ||
        cp == 0x4E94 || cp == 0x516D || cp == 0x4E03 || cp == 0x516B ||
        cp == 0x4E5D || cp == 0x5341 || cp == 0x767E || cp == 0x5343 ||
        cp == 0x4E07 || cp == 0x96F6 || cp == 0x4E24 || cp == 0x3007;
    if (!numeral) return false;
  }
  return false;
}

// 扫目录：独立句柄流式扫标题行（不碰排版游标）。结果缓存到片内 LittleFS
// （键 = 路径哈希，失效键 = 书文件大小；坑 18 后 LittleFS 写是安全的，
// 比每次进目录都全文件重扫强 —— 大文件扫一遍要好几秒）。
bool TxtBook::scanToc() {
  m_nToc = 0;
  if (!m_fs || !m_path[0]) return false;

  uint32_t fsize = 0;
  {
    File f = m_fs->open(m_path, FILE_READ);
    if (!f) return false;
    fsize = f.size();
    f.close();
  }

  char cache[32];
  snprintf(cache, sizeof(cache), "/__toc_%08lx",
           (unsigned long)Bookmarks::hashPath(m_path));
  {
    File c = LittleFS.open(cache, FILE_READ);
    if (c) {
      uint32_t hdr[3];
      if (c.read((uint8_t*)hdr, sizeof(hdr)) == (int)sizeof(hdr) &&
          hdr[0] == 0x31434F54UL /* 'TOC1' 小端 */ &&
          hdr[1] == fsize && hdr[2] <= (uint32_t)TOC_MAX &&
          c.read((uint8_t*)m_tocOff, hdr[2] * 4) == (int)(hdr[2] * 4)) {
        m_nToc = (int)hdr[2];
        c.close();
        return true;
      }
      c.close();
    }
  }

  uint32_t t0 = millis();
  File f = m_fs->open(m_path, FILE_READ);
  if (!f) return false;
  char line[96];
  int ll = 0;
  long lineStart = 0;
  bool sol = true;
  long pos = 0;
  while (pos < (long)fsize) {
    uint8_t buf[512];
    int chunk = f.read(buf, sizeof(buf));
    if (chunk <= 0) break;
    for (int k = 0; k < chunk; k++) {
      char ch = (char)buf[k];
      if (sol) { lineStart = pos + k; sol = false; ll = 0; }
      if (ch == '\n') {
        if (isChapterHeading(line, ll) && m_nToc < TOC_MAX)
          m_tocOff[m_nToc++] = lineStart;
        sol = true;
      } else if (ll < (int)sizeof(line) - 1) {
        line[ll++] = ch;
      } else {
        sol = true;                    // 超长行不可能是标题，放弃本行
      }
    }
    pos += chunk;
  }
  f.close();

  File c = LittleFS.open(cache, FILE_WRITE);
  if (c) {
    uint32_t hdr[3] = { 0x31434F54UL, fsize, (uint32_t)m_nToc };
    c.write((uint8_t*)hdr, sizeof(hdr));
    if (m_nToc) c.write((uint8_t*)m_tocOff, m_nToc * 4);
    c.close();
  }
  Serial.printf("[toc] %s: %d 章 (%lu ms)\n", m_path, m_nToc,
                (unsigned long)(millis() - t0));
  return true;
}
