RobaLinan/dual-ink-reader/(commit log)

2026-09-24 P3 收官：TXT 双屏阅读器 + 三档字号 + 四字体家族 + 霍尔深睡恢复
    - SD 分目录 /fonts /books（根目录旧布局兜底）；冷上电挂载指数退避重试 ×5 +
    根目录探针防半成功挂载（坑 15 定案，修掉冷开候选 1 静默换书）
    - UTF-8 中英混排分页：汉字按字断行、英文按词断、避头尾、纯英文不回退、EOF 回卷
    - 三档字号 16/24/32（串口 s）+ 四家族 EPF1 离线字库 classic/serif/sans/kai
    （mk_fontpack.py 离线光栅化，SD 自动发现，PSRAM/heap/桶缓存三级 + Unifont 回退）
    - 霍尔深睡：合盖 300ms 防抖 → 对页位置存 RTC → SPI 8 脚 gpio_hold → EXT1 深睡；
    开盖唤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
2026-09-28 P4: EPUB 阅读支持(miniz/tinyxml2/Book 抽象)+ SD 写失败诊断自愈
    - Book.h 抽象接口,TxtBook/EpubBook 实现;openBook 切书先 close()
    旧句柄(SD 重挂前必须无打开文件,进度已先存盘)
    - EpubZip 解压提取:失败分类 EXFAIL_ENTRY/IO/VERIFY,写死时跳过
    remove();TextSink 跟踪写错,出错后丢字符不再假装成功
    - EpubBook::extractWithRecovery() 三层自愈:写失败 → 读探针
    ([sdtriage] 判定瞬时/重挂可救/硬死) → Storage::recover() 重挂
    → 重开 zip 重试;CJK.sdOpen() 时跳过重挂
    - Storage::recover(): end+begin(CMD0)带耗时日志
    - CjkFont::sdOpen() 探测 SD 流式句柄
    - miniz + tinyxml2 vendor 源码(src/VENDO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
2026-09-28 P4 修复：EPUB 临时文件改走 LittleFS + 串口收割验证 + 诊断日志清理
    - 坑18：EPUB 临时文件（container/OPF/xhtml/文本）全部改走片内 LittleFS，
    全项目对 SD 零写入（SD 写 ~3KB 驱动层物理锁卡，0x109→0x107 只能断电）；
    EpubZip::extractToFile 增 fs::FS& 参数，TxtBook::open 增 FS 重载
    - 坑19：串口输入三窗口治理——等待期每 20ms 轮询即时执行（原来只在 loop 顶
    读一次，等待期字节被刷新后的 drain 吞掉，7 个 'b' 全灭）；刷新期/开机期
    harvestRx 收割验证（"命令字符+换行"入队补执行，裸字节/乱码打 hex 丢弃，
    纯换行单独记 ignore）；合盖检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
    [EpubBook.cpp, EpubBook.h, EpubZip.cpp, EpubZip.h, TxtBook.cpp, TxtBook.h, eink.ino, one_bit_write.ino]
2026-09-28 竖版页方向：短边为横边（PAGE_ROTATE=90，逻辑画布 480×648）
    - EinkPanel.h 增 PAGE_ROTATE（90=页顶朝屏右边 / 270 反向，可 -DPAGE_ROTATE
    覆盖）与 PAGE_W=480 / PAGE_H=648；旋转交给 GUI_Paint 的 Paint_SetPixel
    逐像素映射（Paint_NewImage 一次定几何，SelectImage 只换指针），零额外缓冲、
    零旋转拷贝，差分/DTM1/R_MIRRORED 仍在显存坐标上原样工作
    - TxtBook 排版改竖版逻辑坐标：HARD_PX 632→464（=PAGE_W-16）、软预算
    616→448、TXT_BOT 462→630（=PAGE_H-18）；每页行数不再写死，
    updateGeometry 统一按墨迹盒算 —— 竖版 33/21/16 行，横版 462 时正好还原
    旧的 24/15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
2026-09-28 P4 插图：EPUB 图片显示（TJpgDec/PNGdec → 1bit 抖动）+ 屏上首测两 bug 修复
    - 管线：collectText 遇 <img>/<image>(svg 封面) 不写文本，写 [[img:zip内路径]]
    标记行（src 相对本章 XHTML：../ 折叠 + # 截锚 + %XX 解码 + 空格转 %20 防拆词）
    → TxtBook 排版到标记 = 独占一块行高：量高（只读文件头）→ 页中放不下整图推
    下页（新增 s_rewindPos，与行回退互补）/ 页首硬压进一页防死循环 → EpubBook
    解压图片条目到 LittleFS 临时文件（同路径缓存防重复解压）→ EpubImg 解码绘制
    - src/EpubImg.cpp（新）：probe 扫 SOF/IHDR 量尺寸（不解码）；draw 等比缩放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
    [EpubBook.cpp, EpubBook.h, EpubImg.cpp, EpubImg.h, TxtBook.cpp, TxtBook.h, eink.ino]
2026-09-28 P4 收官：屏上实测通过，路线表/验收清单标 ✅
    - 路线表 P4：P4 ✅(代码) → P4 ✅，内容补"EPUB 插图"，验收列记录
    章不崩不 OOM / 章间翻页切书进度回页 / 插图清晰不重启 全过
    - P4 与 P4 插图两节头标 ✅ 收官（2026-09-24 主机端验证 → 2026-09-28 屏上实测）
    - 插图验收清单标全过，补第 ⑥ 项：alice_rackham 插图无涂抹、翻图页不重启
    （坑 21 修复后复烧）
    - 下一步 → P5 跨页语义
2026-09-28 P4 验收第⑥项定案：插图灰阶抖动观感可接受、无涂抹、不重启
    - ⑥ 措辞按屏上实测校准：4×4 Bayer 抖动的灰阶观感验收通过，插图显示效果
    到此定案（后续不动解码/抖动参数，只在换屏/换分辨率时重评）
2026-09-28 P6 备料清单 BOM.md（按实际库存校正）+ 路线表 P6 加入口
    - 新增 BOM.md：电源/互连/按键小板/结构件四段 + 到货→装配→验收 checklist，
    依据 DESIGN §1.6、WIRING §3、方案 §1.4
    - 按实际库存标定：ESP32-S3、屏+转接板、SD 模块、DRV5032、静音微动开关 ×4、
    可穿线阻尼铰链、M5×3 磁铁、常用电阻电容 = ✅ 已有
    - 方案随之收敛：铰链已有 → 免掉"布基胶带起步 → 一体铰链件"两步走，
    改为核过线孔径能否容 10 芯排线（不够按 WIRING §3.2 降芯/分束）；
    开关已有 → 按键小板只差基板 + 6P 排线
    - 真正待买收敛到：⚠️ 5V 常开电池包（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
2026-09-28 系统菜单：WiFi 配置/开关、OTA 开关、网页上传电子书（NetSvc + SysMenu）
    - 新增 src/SysMenu.*：墨水屏菜单（左页菜单右页状态），串口 m 开/关，
    j/k/方向键上下、Enter/空格执行、q/m 退出；开菜单全刷、导航快刷，
    菜单开着暂停自动翻页；P6 4 键落地后绑同一 key() 接口
    - 新增 src/NetSvc.*：单 WebServer(80) 随 WiFi 开关起停 —— / 首页、
    /wifi 配置页（扫描选 SSID 存 NVS 重启）、/upload 上传 *.txt/*.epub
    到 SD /books、/update 网页 OTA（Update + 失败 abort 自愈）；
    ArduinoOTA 同一开关（3232 无密码）；WiFi 默认关（DESIGN §2），
    STA 15s 连不上自动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
2026-09-28 SD 写路径复测通过：one_bit_write 升级 v3 分阶段诊断（DESIGN 坑 18 补复测曲线）
    工具 sdcard/one_bit_write v3（编译通过）：
    - esp_log vprintf 钩子截获 IDF 驱动层返回码 —— File.write() 失败只回 0 字节，
    真正的 0x107 超时/0x109 CRC 只在 E(...) 日志里，现在每步失败直接打码+原行
    - 分阶段写 + 整档读回校验：读专项 → 512B×4 → 16KB → 256KB → 2MB，
    报出锁卡的确切字节与是写挂还是读挂；图案按扇区号取值，校验可独立重算
    - 失败自动 end+重挂（CMD0 重初始化）恢复，恢复不过来才判死；连续两档连文件
    都开不了提前作废该频率省时间；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
2026-09-28 坑 18 三轮连跑定案 + NetSvc 上传改 512B 单块写
    工具（one_bit_write v3）：
    - 加"本次开机第 N 次运行"轮次计数，用来判"只有上电首轮能过"
    - 加 smallOk 判读分支：4KB 多块挂而 512B 单块过 2MB = 分块是决定性变量
    - 锁死提示改成"f.close 没提交 size → 文件只剩 0 字节壳"
    固件（NetSvc 上传 /books）：
    - HTTP 分块先在 m_upBuf 攒够 512B 再落盘 → 每次 f_write 恰好一个扇区，
    强制走单块 CMD24（实测 4KB 多块 3/3 必挂、512B 单块能过 2MB，速度同 0.25MB/s）
    - 落盘字节与 u.totalSize 对账 + close 后回读校验 size（防报"成功"实为 0 字节）
    - 失败先 Storage::reco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
2026-09-28 坑 18：固件 512B 分块首测仍失败 + recover 假阳性（挂载≠能写）
    实测（上传 /books/03最后的守护者.txt）：
    - 512B 单块写路径照样触发写失败 → 软件侧缓解到此为止
    - 日志 [SD] recover: OK (40ms) 之后紧跟 sdmmc_write_blocks failed (263)：
    那是 recover 之后的 SD_MMC.remove() 又写不进去 → **恢复成功是假阳性**
    （判据只到"挂载 + 开根目录"，不验写），与工具 10MHz 轮同症状
    改动：
    - Storage.h 给 recover() 补上"OK ≠ 卡能写"的告诫，防下一个人再踩
    - NetSvc::upAbort 打印已写字节数，下次测能直接看到失败点
    - DESIGN 坑 18 末段 / §5.7 记录首测结果；硬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
    [NetSvc.cpp, Storage.h]
2026-09-28 坑 18 二次实测：512B 分块挂 @29696 字节，且纯 0x107 无 0x109
    NetSvc 真实上传（/books/03最后的守护者.txt，289.6kB）第二次：
    - 512B 单块写在 29696 字节（58 扇区、约全文件 10%）挂 → 分块缓解证伪
    - 这次只有 sdmmc_host_wait_for_event 0x107（数据相超时），一个 0x109 都没有
    → 卡收下命令、数据相却不肯放 BUSY = 卡没完成编程
    → 0x109 不是坑 18 的必要指纹，只是同根因的另一面
    - one_bit_write 判读口径：0x109 从"坑 18 指纹"降级为"充分非必要"；
    纯 0x107 兜底分支写明主形态与方向（换卡 + 去耦 + 47k）
    - DESIGN 坑 18 末段补二次实测、§5.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
2026-09-29 文档同步 PCB 制图定案 + 加入原理图 PDF
    - PCB/: 加入 SCH_Schematic1_2026-09-29.pdf
    - WIRING: §3.4 按键改主板板载 U1–U4（上拉在主板侧，信号取上拉脚）；
    §3.3 H4 microSD / §3.5 H5 霍尔 按原理图飞线芯序；§3.6 BAT_SENSE
    软件滤波、不加电容；§1 GPIO 总表 + §4 checklist 同步；§3 加位号对照
    - BOM: 去按键小板/6P 排线，改板载按键；霍尔(H5)/电池(H1) 飞线
    - DESIGN: P6 板载按键（无独立小板）、电量检测软件滤波
2026-09-29 PCB: 用 EasyEDA Pro 工程替换导出的 PDF
    - 删除 PCB/SCH_Schematic1_2026-09-29.pdf，加入 PCB/double_eink_reader.eprj2
    - WIRING: 原理图引用改指 EDA 工程文件
2026-09-29 原理图复核（2026-09-29 导出）+ 文档同步
    - PCB: 更新 double_eink_reader.eprj2，加入新导出 SCH_Schematic1_2026-09-29.pdf
    - 复核通过：4 个按键 BTN_* 已落在带上拉的一脚，GND 在另一脚
    - 新变化：删除 BAT_SENSE 电量分压（GPIO8 空出）；新增 Ams1117
    (AMS1117-3.3 回退，R12/R13 0Ω) 与 Pow 入口 R14 0Ω；位号改功能名
    (Pow/EinkLeft/EinkRight/SDCard/Hall/Btn_*)
    - WIRING: §1/§3/§4 同步，新增 §3.8 Ams1117（默认 DNP + 并联 LDO 警告）
    - BOM / DESIGN: 同步位号、删 100kΩ、加 0Ω、电量改"当前不用"
2026-09-29 PCB: 更新 EDA 工程；Gerber 导出与备份不入库
    - PCB/double_eink_reader.eprj2：导出 Gerber 后的工程改动
    - .gitignore：忽略 PCB/*.zip（Gerber 导出）与 PCB/*_backup/
2026-09-30 init cad files
    [E-book-PartLeft.3mf, E-book-PartRight.3mf, E-book.FCStd, Screen.FCStd, cl8006.FCStd]
2026-10-08 按键电气台架 key_test 首测通过 + 唤醒定案：只霍尔走 EXT1
    - 新增 key_test/：4 键去抖/计数/combo 台架（20ms 去抖、心跳电平、bnc 毛刺计数）
    - 实测：空闲 4 脚全高（BTN_* 误标 GND 坑排除）、4 键各 10 次不漏不错位、
    bnc=0、2/3/4 键 combo 计数同步无连锡、静置 80s 电平恒高；长按 115–800ms
    - 定案：按键不参与唤醒，只有霍尔走 EXT1 → eink.ino 的 ANY_HIGH 不动，
    极性冲突消失；代价=合盖睡时按键不叫醒（开盖醒→按键翻页）
    - 文档同步：WIRING 头注/§1/§3.4/checklist、DESIGN §1.1/§4 P6 进行中、BOM checklist
2026-10-08 P6 4 键逻辑：src/Keys 事件模型 + 翻页/菜单/字号绑定 + 自动翻页默认关
    - 新增 src/Keys.h/.cpp：ISR 边沿队列(16 槽) + poll 判定 —— 刷新阻塞 1.3s/3.8s
    期间轮询会整段漏按压，ISR 只记 (时刻,脚,电平)，去抖 20ms/长按 600ms/连发
    300ms（key_test 实测按住 115–800ms）；醒后被按住的键不补发按下
    - eink.ino：turnPage()+对页历史栈 48 深（Book 接口只前进，Prev 靠 restorePair
    坐标回退），连按并批成净位移（一次刷新内攒下的按压跨 N 页只刷一次屏）；
    drainKeys/keyAction 分发，applyMenuResult 抽出串口/按键共用
    - 键位：Prev/Next 翻页(长按连发)、Menu 开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
2026-10-09 CAD: 外壳装配更新（FCStd 落最新 + 零件 3mf/PCB step 导出）
    - E-book.FCStd 更新（PartCover 拆件、打印配置导出）
    - 新增 E-book-PartCover.3mf / print_profile.3mf / 3D_PCB1_2026-10-01.step
    - FreeCAD 备份按既有习惯入库（旧 .FCBak 被新备份替换）
    [3D_PCB1_2026-10-01.step, E-book-PartCover.3mf, E-book.FCStd, print_profile.3mf]
2026-10-09 P7 选书主页：Menu 短按=主页 / 长按=系统菜单（src/HomePage + UiDraw）
    主页（src/HomePage.*，DESIGN §9）：
    - 左页书库列表（'>' + 下划线 + [txt]/[epub]/[在读]），右页正在读·书库统计·
    按键说明；Font 短按 = 打开选中书（选中正在读的那本 = 只回阅读页，进度不动；
    换书走 openBook + NVS 单槽覆盖，从第 0 对页起，同串口 b）
    - Menu 短按 = 主页（全刷）/ 长按 250ms = 系统菜单（全刷）—— 选书与设置分层：
    按下不表态，等 LONG/RELEASE 分岔（RELEASE.longFired 天然区分短/长按）；菜单内
    按 Menu 退出发生在 PRESS，这次按住余下的 LONG/RELEASE 用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
2026-10-09 分区表定案：根目录 partitions.csv（app3M_fat9M_16MB 布局 ffat→spiffs）+ DESIGN 坑22/FQBN/验收数字同步
    [partitions.csv]
2026-10-12 P6 收官：UI 美化（主页/菜单选中三角+粗下划线+分节标记+状态圆点+居中页脚）+ DESIGN P5/P6 标完成 + CAD 外壳更新
    [E-book-LeftCover001.3mf, E-book-PartLeft.3mf, E-book-PartLeftCover.3mf, E-book-PartRight.3mf, E-book-PartRightCover.3mf, E-book.FCStd, print_profile.3mf]
2026-10-12 阅读功能 + 网页调试台：书签/目录/进度%/删书 + /debug 面板降级与串口日志镜像
    - 数据层：Book 扩展 permille()/toc/jumpPermille；EpubZip::forEach 一次 O(N)
    遍历建章权重表；TxtBook 目录启发式扫描缓存
    - UI 层：新增 src/ListPage.*（通用滚动列表）、src/Bookmarks.*（NVS 书签，每书 16 条）
    书页 Menu 长按=阅读菜单，主页 Font 长按=删书确认屏（DESIGN §10）
    - 网页：/library 书库下载/删除；/upload /update 改 XHR 实时进度条
    - /debug 调试台（DESIGN §11）：设备/屏幕/存储/按键状态 + 复位面板/重画/翻页/重启；
    setup() 面板 begin 失败不再 FATAL 卡死（单屏/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
    [E-book-LeftCover001.3mf, E-book-PartRightCover.3mf, E-book.FCStd]
2026-10-13 漫画对页排版：图标记空格接排 + EPUB 空白页跳过（TxtBook s_hadContent / renderPair guard）+ tools/pair_manga_epub.py 一图一章合并对页章
    双屏一屏对页 = 左右面板各一页；漫画 EPUB 一章一张整页图时右面板只剩
    页码空白页。固件三处小改配套书侧两两合并：emitImageMarker 前后分隔
    nl()→sep()/空格（换行先占空行会把右页图挤走）、renderPage 无内容页
    对 EPUB 返回 false、左页跳过循环 guard 封顶。全书仿真 93 章全部
    图|图满对，仅封面/奇数尾页右页空白。DESIGN §12。
2026-10-13 EPUB 同章回退不再重载章节：restorePair 仅跨章才 loadChapter（同章只 seek），修 Prev 翻页卡几秒到十几秒
2026-10-14 双核缓存修开机死锁（SdMuGuard 改 Recursive API）+ 开机预填历史栈 + 系统菜单全刷间隔可调(5-15)
    - EpubBook SdMuGuard 改用 xSemaphoreTakeRecursive/GiveRecursive，修递归取锁死机
    - prefetchInit 仅建同步原语，pfEnsure 在 WiFi 关闭后才建 core0 任务（避坑25）
    - 开机恢复后预填历史栈（jumpPermille 每 10‰ 采样），Prev 可翻回启动前
    - FULL_EVERY 改为可变变量，SysMenu 第 5 项「全刷间隔」5-15 循环，NVS 持久化
    - 清掉全部调试打印
    [E-book-LeftCover001.3mf, E-book-PartCover.3mf, E-book-PartLeft.3mf, E-book-PartLeftCover.3mf, E-book-PartRight.3mf, E-book-PartRightCover.3mf, E-book.FCStd, print_profile.3mf]
2026-10-14 EPUB 预取崩溃修复：extractToBuffer 改迭代式 API（tinfl 32 位越界踩栈帧的根因）
    extractToBuffer 用 extract_to_callback 把 tinfl_decompressor ~8.2KB 放栈上，
    xtensa 32 位越界写（上游 miniz#371）踩坏栈帧 → StoreProhibited @ 0x120d0e07
    确定性崩溃。改走 extract_iter_* 迭代式 API，解压器堆分配（+4096 slack 兜底），
    同 extractToFile 的路径，附带坑 17 CRC 回填。
    附带：预取任务 pinned core1（与 m_zip 同核共享 SD 句柄）、32KB 栈、
    collectText 改迭代（防递归栈溢出）、TextSink 缓冲堆分配、WiFi 门控去掉。
    [EpubBook.cpp, EpubZip.cpp, EpubZip.h, eink.ino]
2026-10-14 清理敏感目录 + 添加 README
    - 从 git 追踪中移除 .zcode/（Qoder 内部目录），加入 .gitignore
    - 新增 README.md：项目概述、硬件、功能、结构、编译说明
2026-10-14 添加实物照片：TXT 阅读 + 漫画对页
